AxLab-UofC/GranularIO/Hardware/LAPM/4_MotherBoard_PCB/readme.md

# MotherBoard PCB
## Why are there no BOM and Pos files?
This mother board is mainly for connecting motordrivers and 4 x teensy 3.2. The main components are pin headers and sockets with 2.54mm spacing.

## Publication

**Granular I/O: Enabling Bi-directional Malleable Interaction for Actuated TUIs with Magnetic Particles**  
Chi Wang, Clara Cui, Alan Pham, Justice T Andersen, Tucker Rae-Grant, and Ken Nakagaki.  
*ACM Symposium on User Interface Software and Technology (UIST), 2026.*  
https://doi.org/10.1145/3830398.3830589
