AxLab-UofC/GranularIO/Hardware/EM/EM_Bottom.png

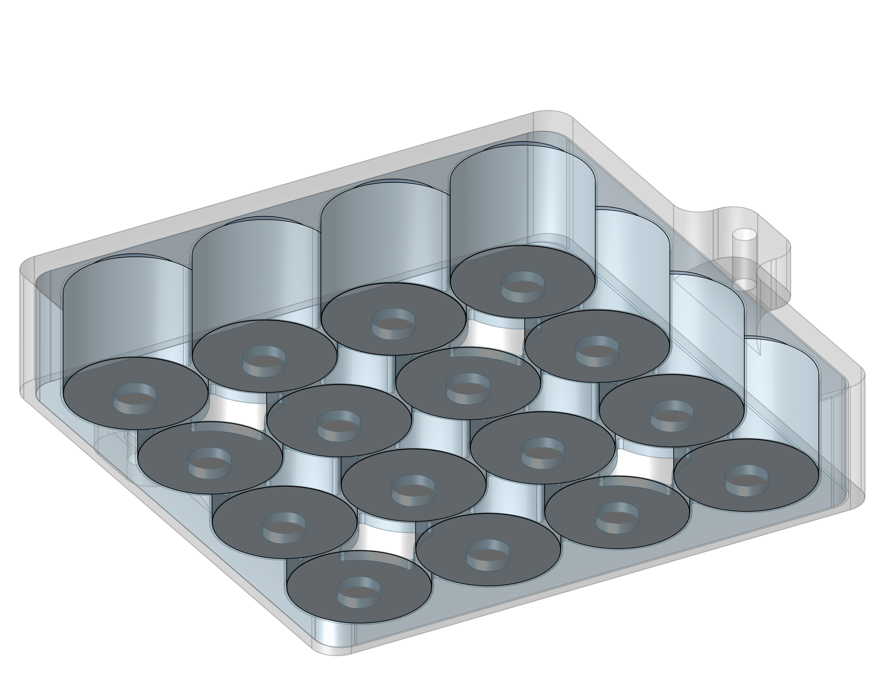
Hardware/EM/EM_Bottom.png
