AxLab-UofC/GranularIO/Hardware/LAPM/5_MotorDriver_PCB/MotorDriver_BOM.csv

Reference | Qty | Value | DNP | Exclude from BOM | Exclude from Board | Footprint | Datasheet | LCSC
C1,C2 | 2 | 47uF/16V |  |  |  | Capacitor_SMD:CP_Elec_6.3x5.4 | ~
C3,C4 | 2 | 10uF |  |  |  | Capacitor_SMD:C_0603_1608Metric_Pad1.08x0.95mm_HandSolder | ~
C5 | 1 | 0.1uF |  |  |  | Capacitor_SMD:C_0603_1608Metric_Pad1.08x0.95mm_HandSolder | ~
D1 | 1 | LED |  |  |  | LED_SMD:LED_0603_1608Metric_Pad1.05x0.95mm_HandSolder | ~
J1 | 1 | Conn_01x12_Pin |  |  |  | Connector_PinHeader_2.54mm:PinHeader_2x06_P2.54mm_Vertical_SMD | ~ | C22395610
J2,J3 | 2 | Conn_01x01_Pin |  |  |  | Connector_PinHeader_2.54mm:PinHeader_1x01_P2.54mm_Vertical | ~
JP1,JP2,JP3,JP4,JP5 | 5 | ~ |  | Excluded from BOM |  | Jumper:SolderJumper-2_P1.3mm_Open_RoundedPad1.0x1.5mm | ~
M1,M2,M3,M4 | 4 | N20Motor |  |  |  | N20Motor:N20MotorConn | ~
R9 | 1 | 1k |  |  |  | Resistor_SMD:R_0603_1608Metric_Pad0.98x0.95mm_HandSolder | ~
RN1,RN2 | 2 | 10k |  |  |  | Resistor_SMD:R_Array_Convex_4x0603 | ~ | C29718
U1 | 1 | PCA9685PW |  |  |  | Package_SO:TSSOP-28_4.4x9.7mm_P0.65mm | http://www.nxp.com/docs/en/data-sheet/PCA9685.pdf | C2678753
U2,U3 | 2 | TB6612FNG |  |  |  | Package_SO:SSOP-24_5.3x8.2mm_P0.65mm | https://toshiba.semicon-storage.com/us/product/linear/motordriver/detail.TB6612FNG.html | C141517
