AxLab-UofC/GranularIO/Hardware/EM/1_EM_Cover.stl

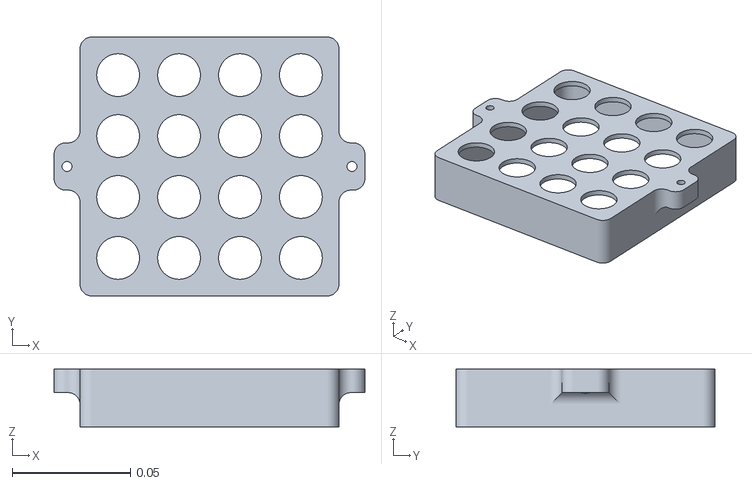
[picture p6: CAD file, 2026-11-02]
Hardware/EM/1_EM_Cover.stl
0.131 x 0.109 x 0.0245
