AxLab-UofC/GranularIO/Hardware/LAPM/1_Rail_Array.stl

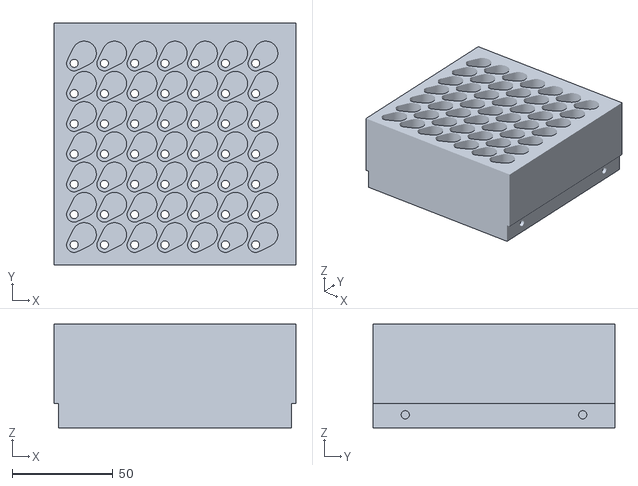
[picture p7: CAD file, 2026-11-02]
Hardware/LAPM/1_Rail_Array.stl
120.0 x 120.0 x 51.5
