AxLab-UofC/GranularIO/Hardware/LAPM/4_MotherBoard_PCB/MotherBoard_3D_Model.step

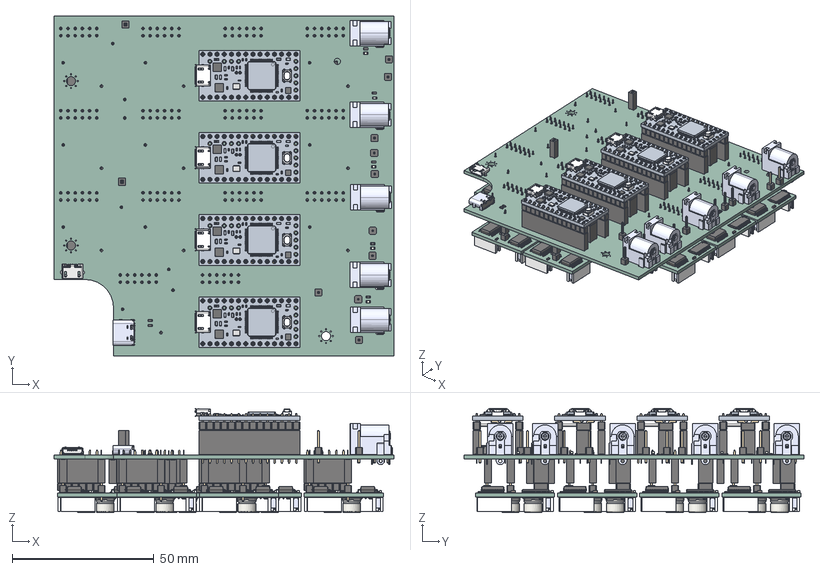
[picture p9: CAD file, 2026-10-10]
Hardware/LAPM/4_MotherBoard_PCB/MotherBoard_3D_Model.step
120.0 x 120.0 x 36.9 mm
PinSocket_2x06_P2.54mm_Vertical x 18
PinSocket_1x01_P2.54mm_Vertical x 36
C_0603_1608Metric x 42
PinHeader_2x06_P2.54mm_Vertical_SMD x 18
PinHeader_1x01_P2.54mm_Vertical x 38
R_Array_Convex_4x0603 x 28
R_0603_1608Metric x 21
SSOP-24_5.3x8.2mm_P0.65mm x 28
TSSOP-28_4.4x9.7mm_P0.65mm x 14
LED_0603_1608Metric x 19
BxB-ZR-SM4_6 x 56
BxB-ZR-SM4 pins_6 x 56
CP_Elec_6.3x5.4 x 28
MotorController_PCB x 14
PinSocket_1x14_P2.54mm_Vertical x 8
PinHeader_1x14_P2.54mm_Vertical x 8
PJ-002B x 5
MCR-B-S-RA-SMT-CS5A-NF-T_R
USB4105GFA_USB4105GFA
MotorHub5x5_PCB
