AxLab-UofC/GranularIO/Hardware/LAPM/5_MotorDriver_PCB/MotorDriver_3D_Model.step

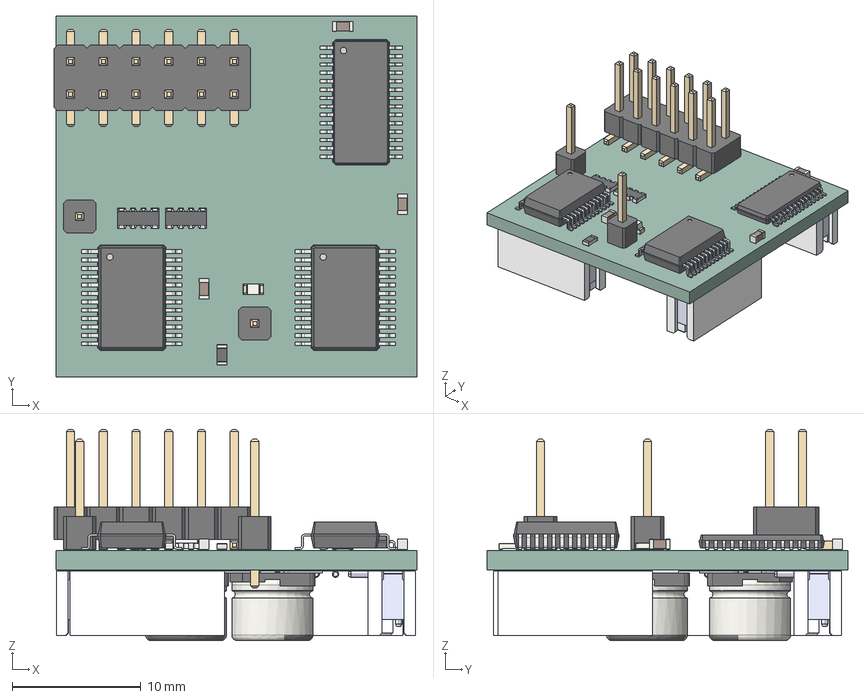
[picture p10: CAD file, 2026-10-10]
Hardware/LAPM/5_MotorDriver_PCB/MotorDriver_3D_Model.step
28.1 x 28.0 x 16.4 mm
C_0603_1608Metric x 3
PinHeader_2x06_P2.54mm_Vertical_SMD
PinHeader_1x01_P2.54mm_Vertical x 2
R_Array_Convex_4x0603 x 2
R_0603_1608Metric
SSOP-24_5.3x8.2mm_P0.65mm x 2
TSSOP-28_4.4x9.7mm_P0.65mm
LED_0603_1608Metric
BxB-ZR-SM4_6 x 4
BxB-ZR-SM4 pins_6 x 4
CP_Elec_6.3x5.4 x 2
MotorController_PCB
