AxLab-UofC/GranularIO/Hardware/EM/2_EM_Hub.stl

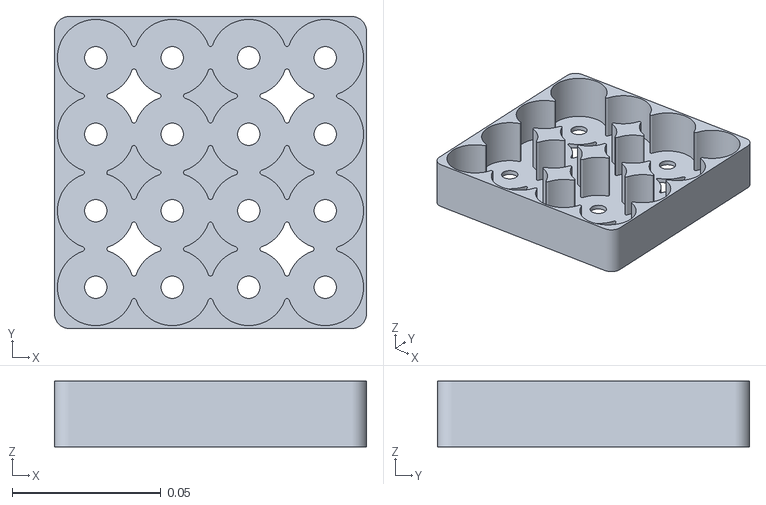
[picture p11: CAD file, 2026-11-02]
Hardware/EM/2_EM_Hub.stl
0.105 x 0.105 x 0.0221
