AxLab-UofC/GranularIO/Hardware/LAPM/2_Motor_Hub.stl

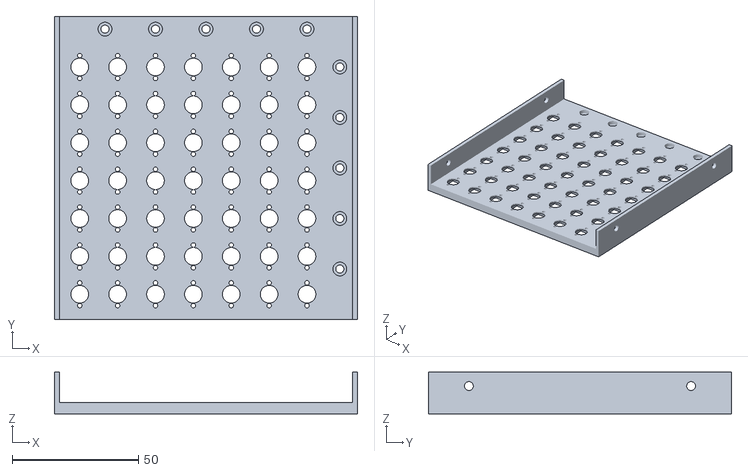
[picture p12: CAD file, 2026-11-02]
Hardware/LAPM/2_Motor_Hub.stl
120.0 x 120.0 x 16.5
