AxLab-UofC/GranularIO/Hardware/LAPM/3_Supporting_Beams/3_Supporting_Beam_d.stl

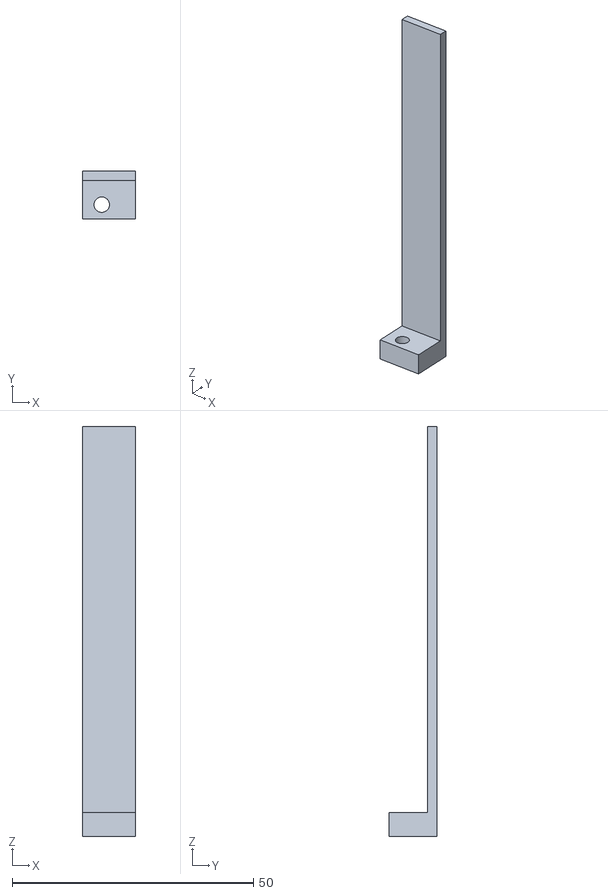
[picture p13: CAD file, 2026-11-02]
Hardware/LAPM/3_Supporting_Beams/3_Supporting_Beam_d.stl
11.0 x 10.0 x 85.0
