AxLab-UofC/GranularIO/Hardware/LAPM/6_Pin/6_3_Encoder_Cap.stl

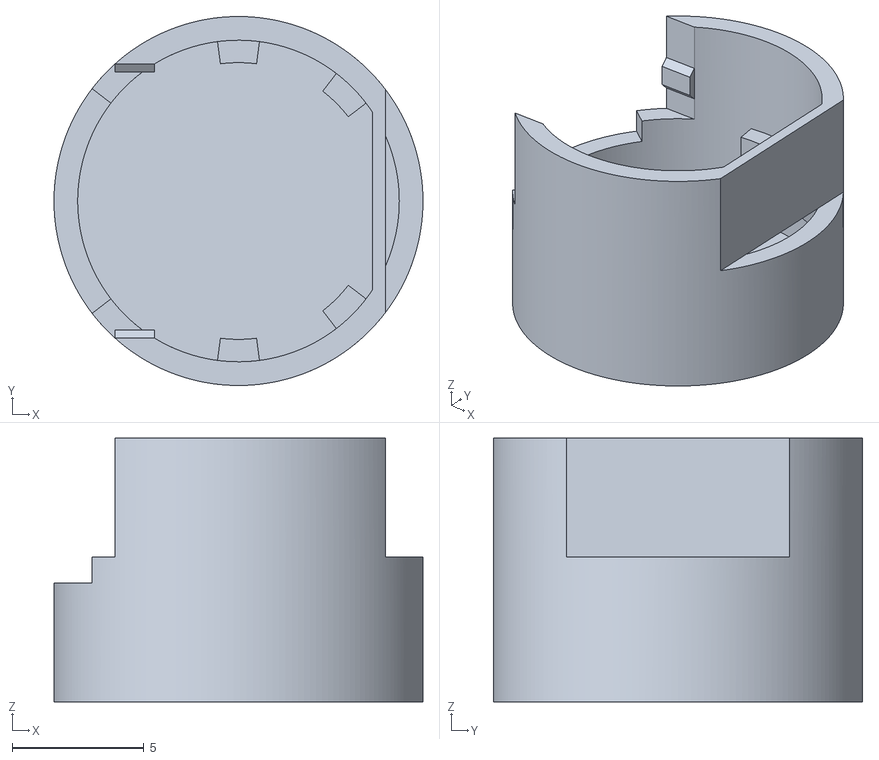
[picture p14: CAD file, 2026-11-02]
Hardware/LAPM/6_Pin/6_3_Encoder_Cap.stl
14.0 x 14.0 x 10.0
