AxLab-UofC/GranularIO/Hardware/EM/3_MetalDisk.step

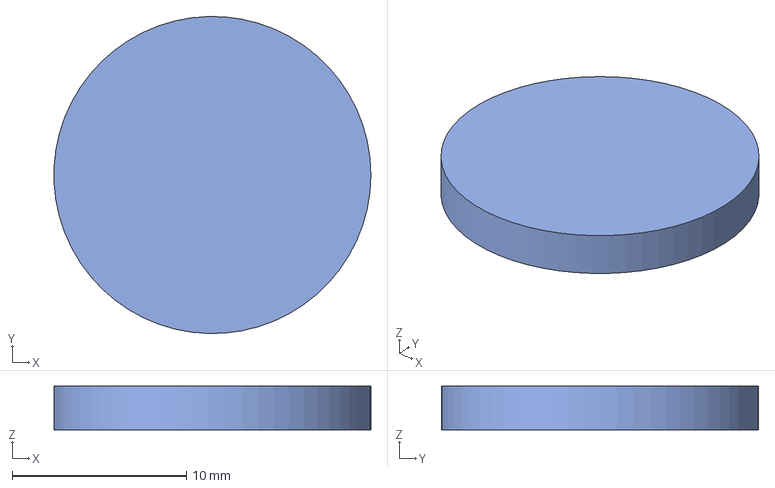
[picture p15: CAD file, 2026-11-02]
Hardware/EM/3_MetalDisk.step
18.2 x 18.2 x 2.50 mm
