AxLab-UofC/GranularIO/Hardware/LAPM/3_Supporting_Beams/3_Supporting_Beam_c.stl

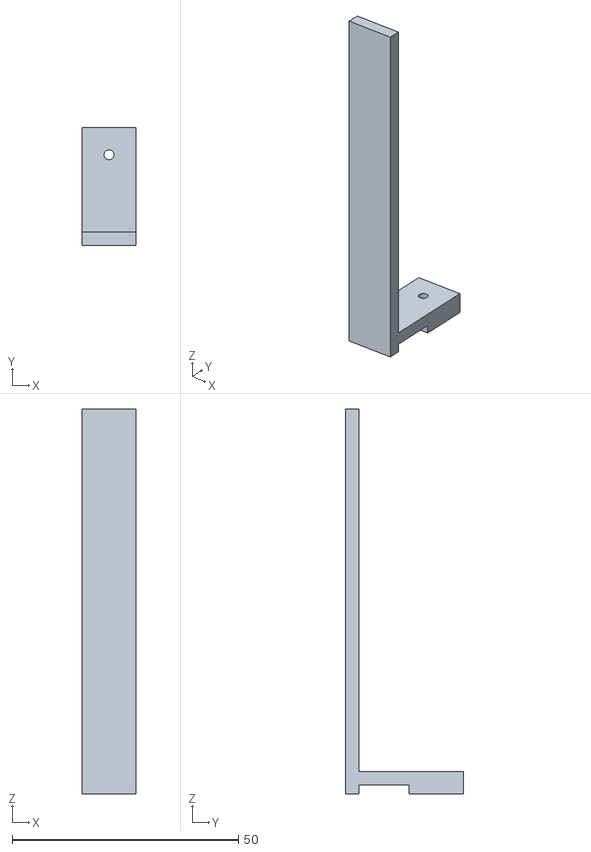
[picture p16: CAD file, 2026-11-02]
Hardware/LAPM/3_Supporting_Beams/3_Supporting_Beam_c.stl
12.0 x 26.0 x 85.0
