AxLab-UofC/GranularIO/Hardware/LAPM/6_Pin/6_1_Magnet_Holder.stl

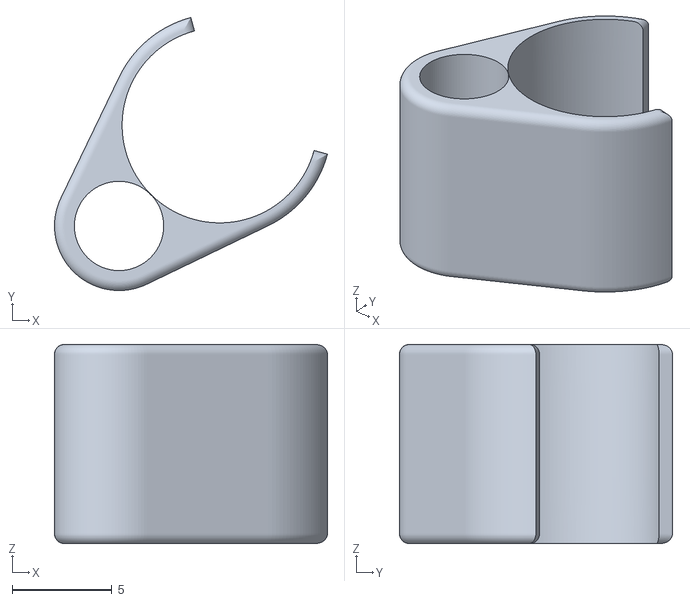
[picture p17: CAD file, 2026-11-02]
Hardware/LAPM/6_Pin/6_1_Magnet_Holder.stl
13.7 x 13.7 x 10.0
