AxLab-UofC/GranularIO/Hardware/LAPM/3_Supporting_Beams/3_Supporting_Beam_b.stl

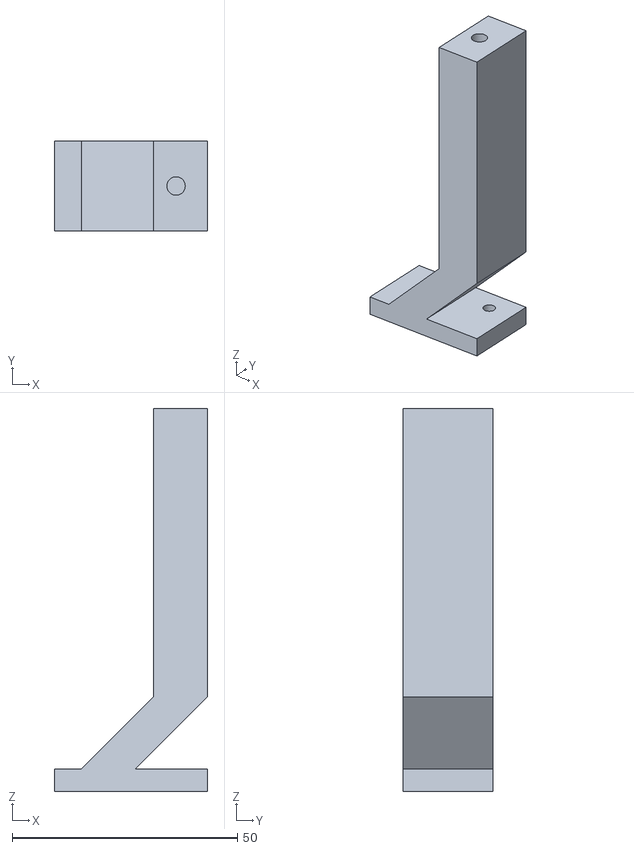
[picture p18: CAD file, 2026-11-02]
Hardware/LAPM/3_Supporting_Beams/3_Supporting_Beam_b.stl
34.0 x 20.0 x 85.0
