AxLab-UofC/GranularIO/Hardware/LAPM/6_Pin/6_2_Screw_Connector.stl

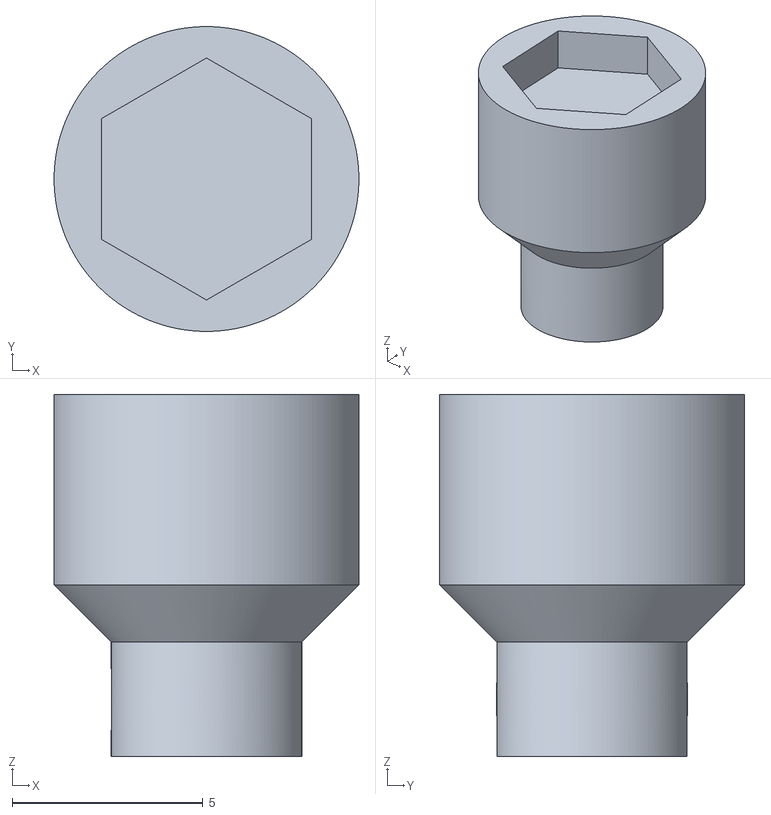
[picture p19: CAD file, 2026-11-02]
Hardware/LAPM/6_Pin/6_2_Screw_Connector.stl
8.00 x 8.00 x 9.50
