AxLab-UofC/GranularIO/(list of files, cad)

Other CAD files:
Hardware/Particles/Sphere_5mm_mini.3mf
Hardware/Particles/Sphere_5mm_support_test.3mf
