AxLab-UofC/GranularIO/Hardware/LAPM/4_MotherBoard_PCB/MotherBoard_PCB_B.pdf

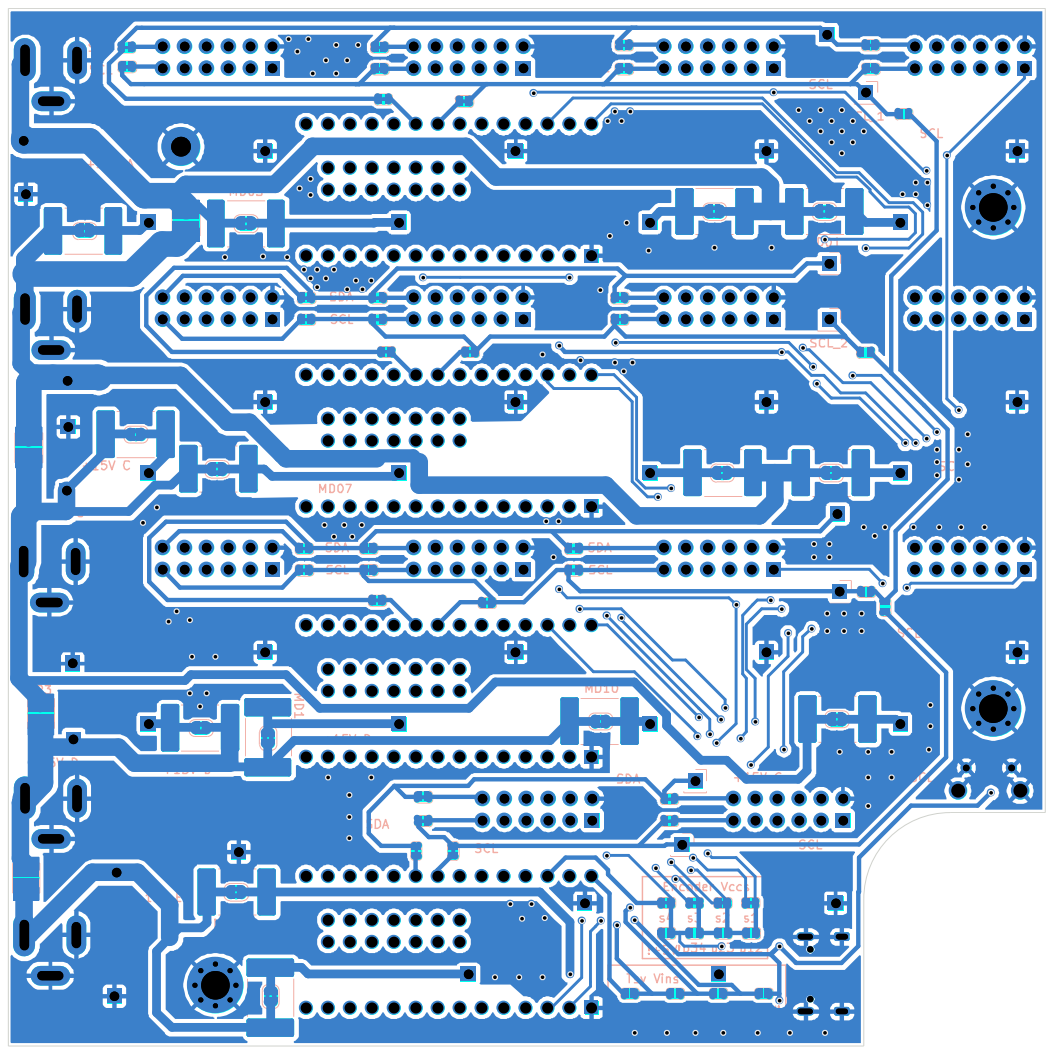
[picture p20: page 1]
