AxLab-UofC/GranularIO/Hardware/LAPM/4_MotherBoard_PCB/MotherBoard_PCB_F.pdf

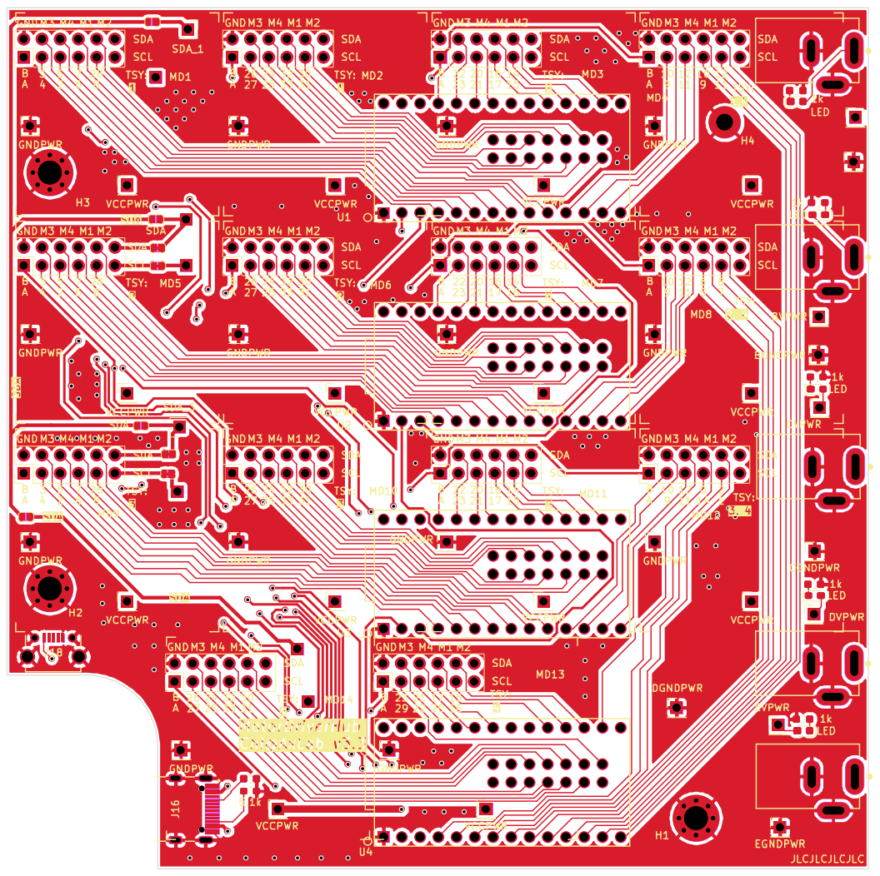
[picture p21: page 1]
