AxLab-UofC/GranularIO/Hardware/LAPM/4_MotherBoard_PCB/MotherBoard_Schematic.pdf

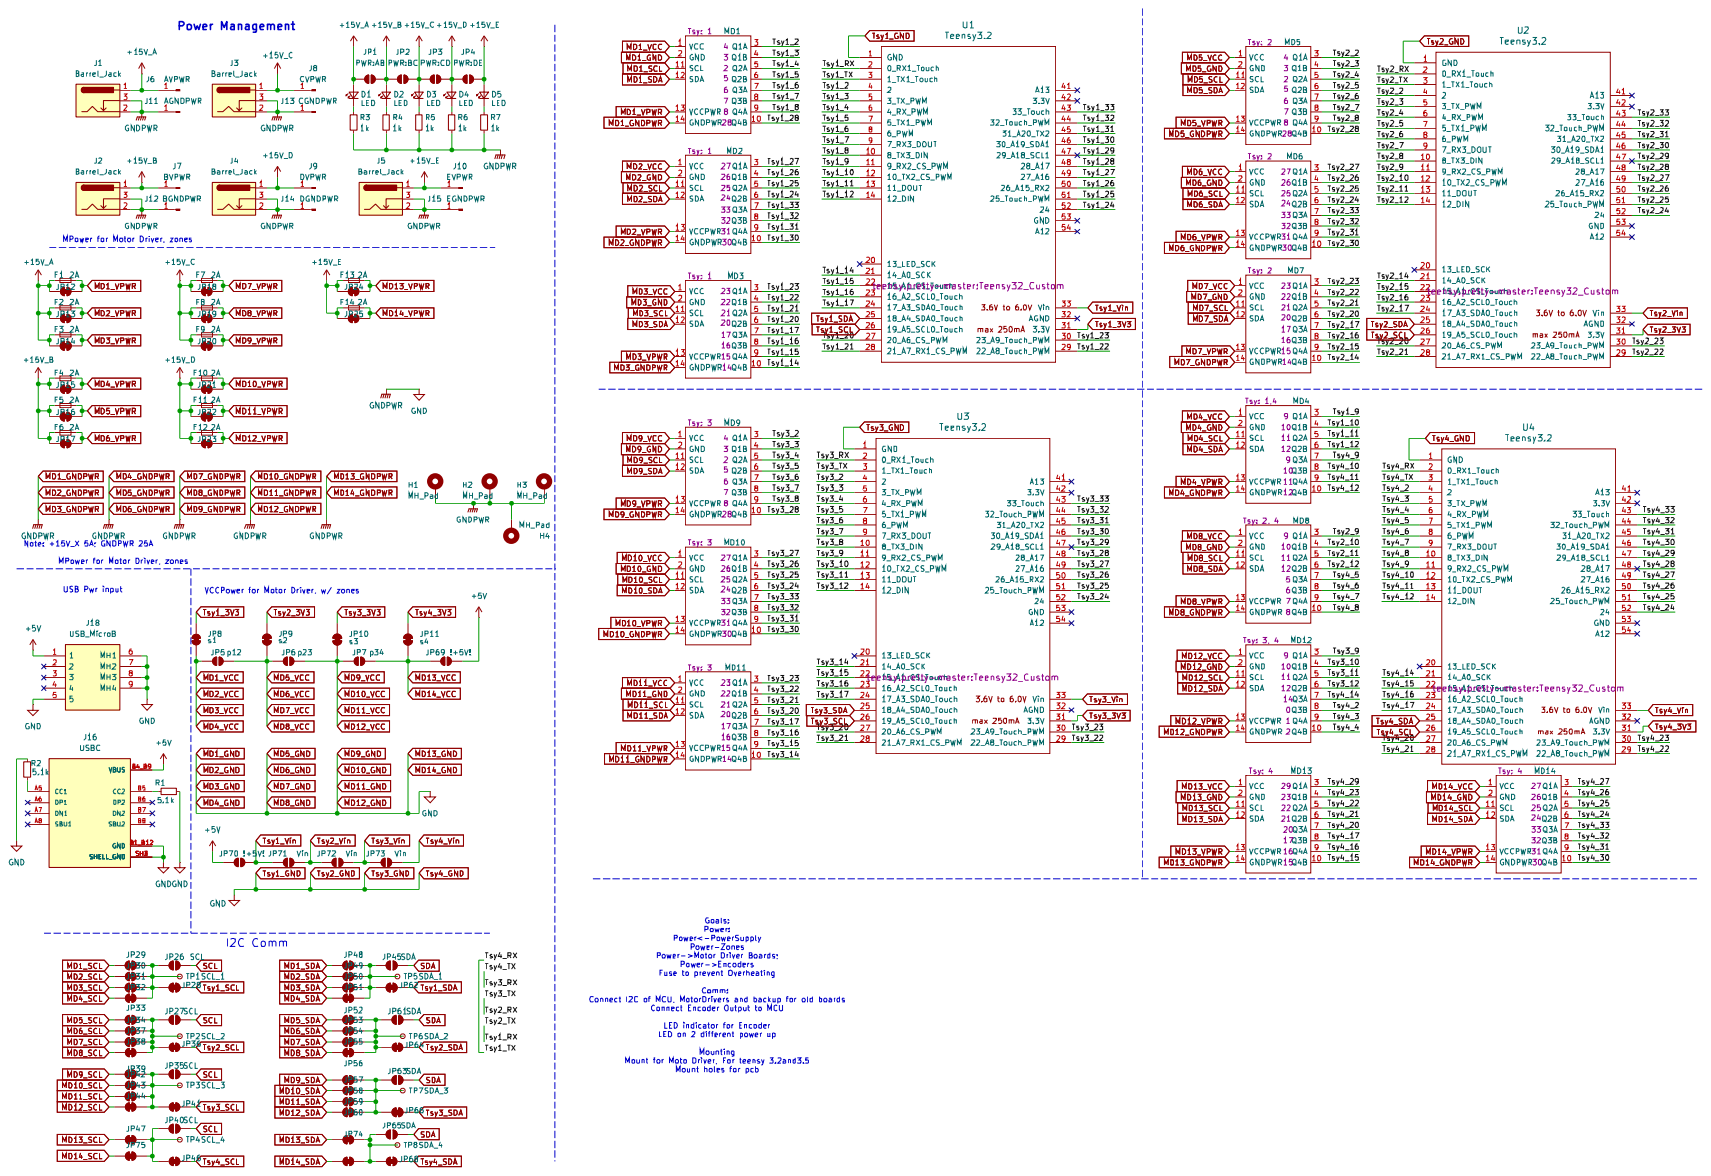
[picture p22: page 1]
