AxLab-UofC/GranularIO/Hardware/LAPM/5_MotorDriver_PCB/MotorDriver_PCB_B.pdf

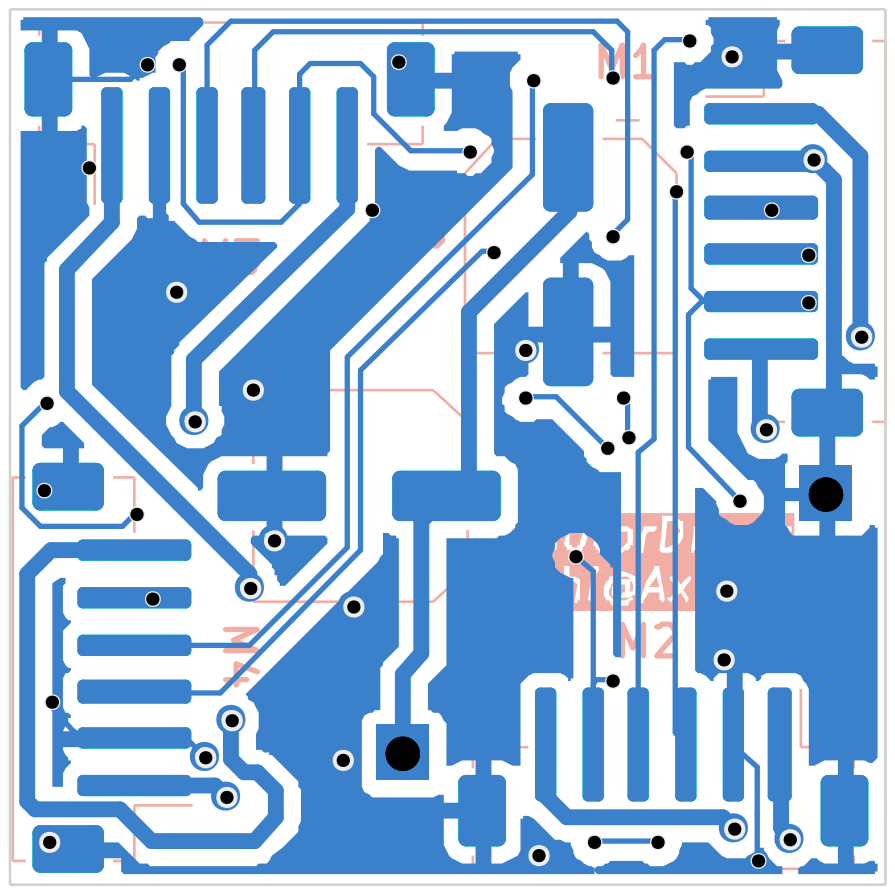
[picture p23: page 1]
