AxLab-UofC/GranularIO/Hardware/LAPM/5_MotorDriver_PCB/MotorDriver_PCB_F.pdf

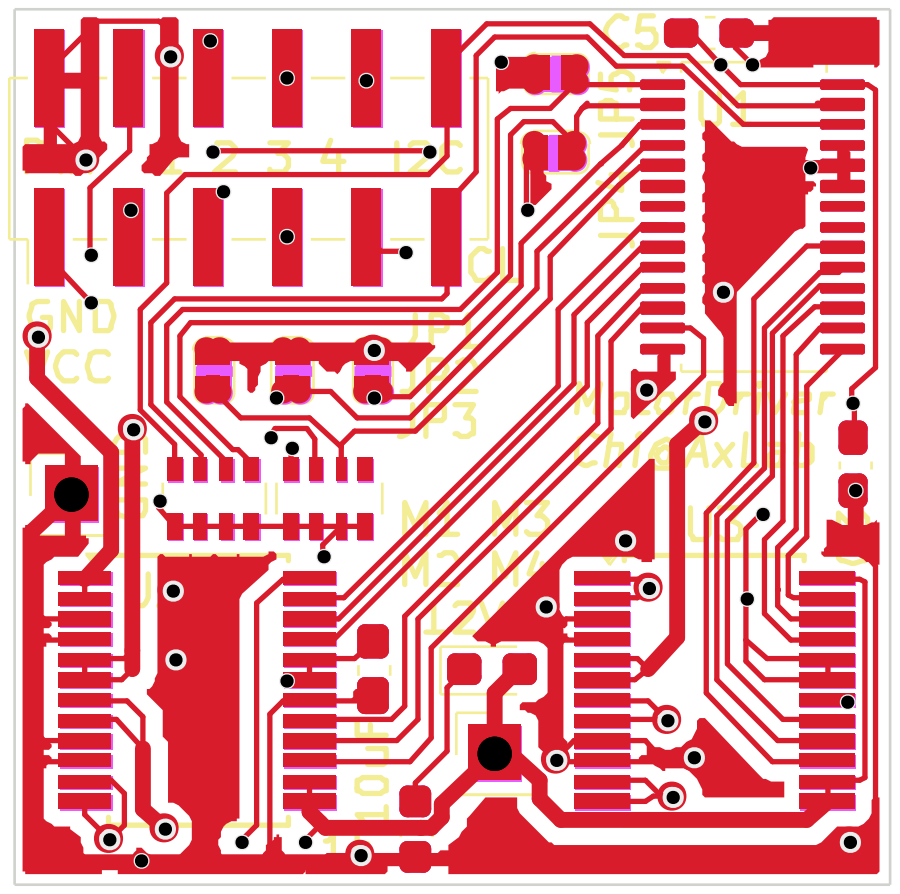
[picture p24: page 1]
