AxLab-UofC/GranularIO/Hardware/LAPM/5_MotorDriver_PCB/MotorDriver_Schematic.pdf

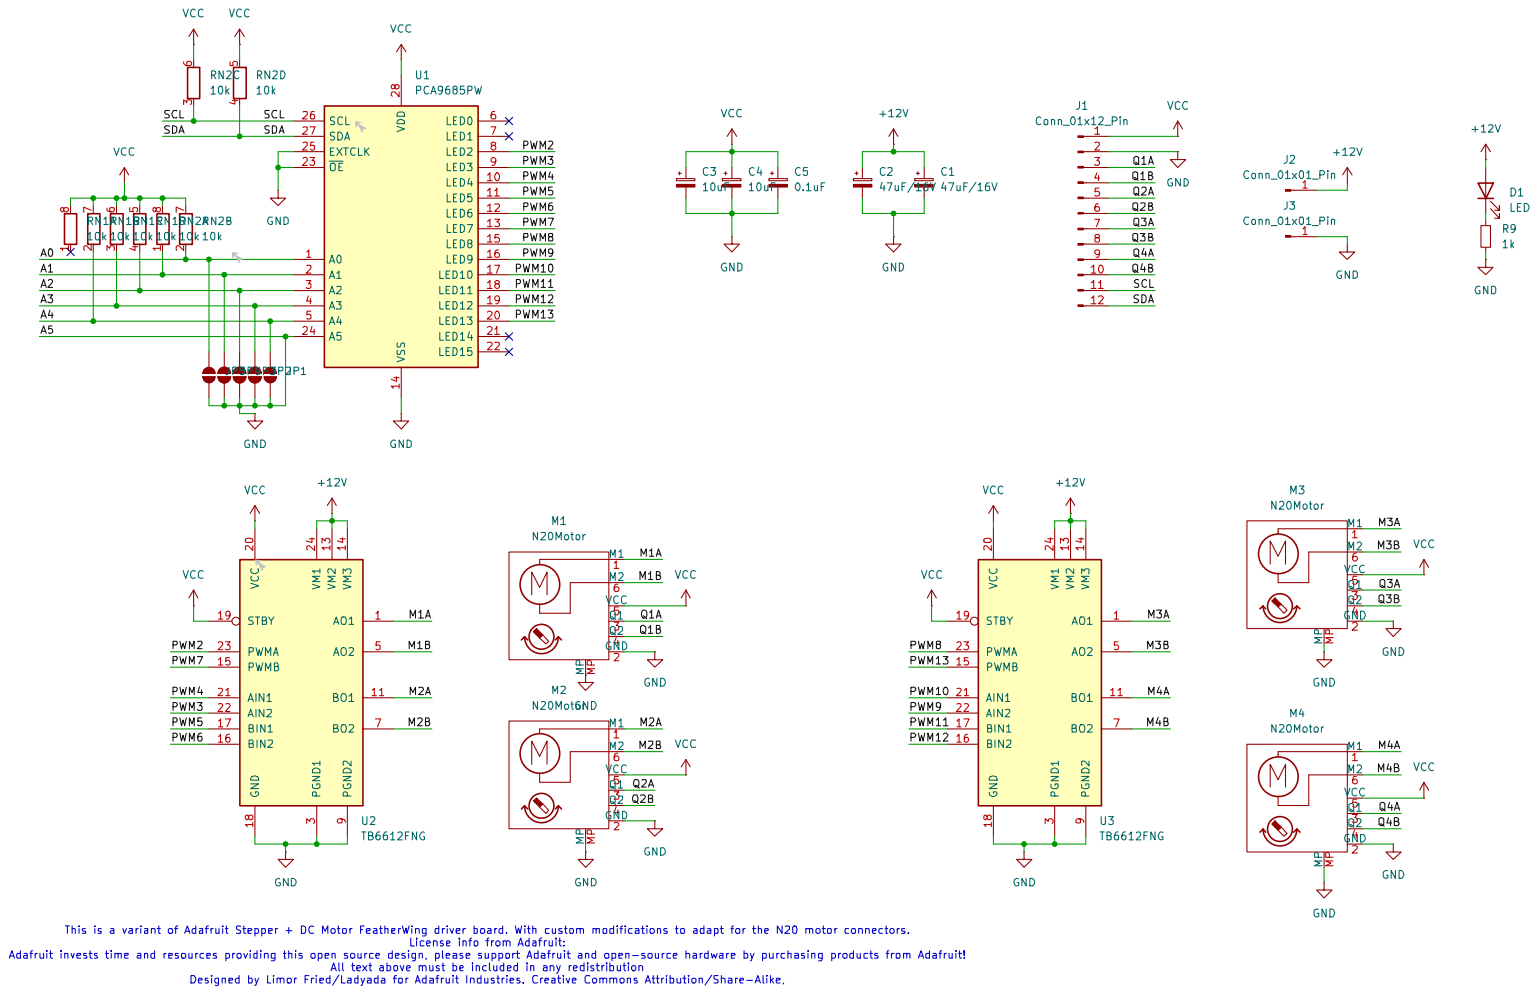
[picture p25: page 1]
