AxLab-UofC/GranularIO/Hardware/LAPM/PCB Kicad Files/4_MotherBoard_PCB/MotorHub5x5.kicad_pcb

## KiCad design Hardware/LAPM/PCB Kicad Files/4_MotherBoard_PCB/MotorHub5x5.kicad_pcb (2026-10-10)

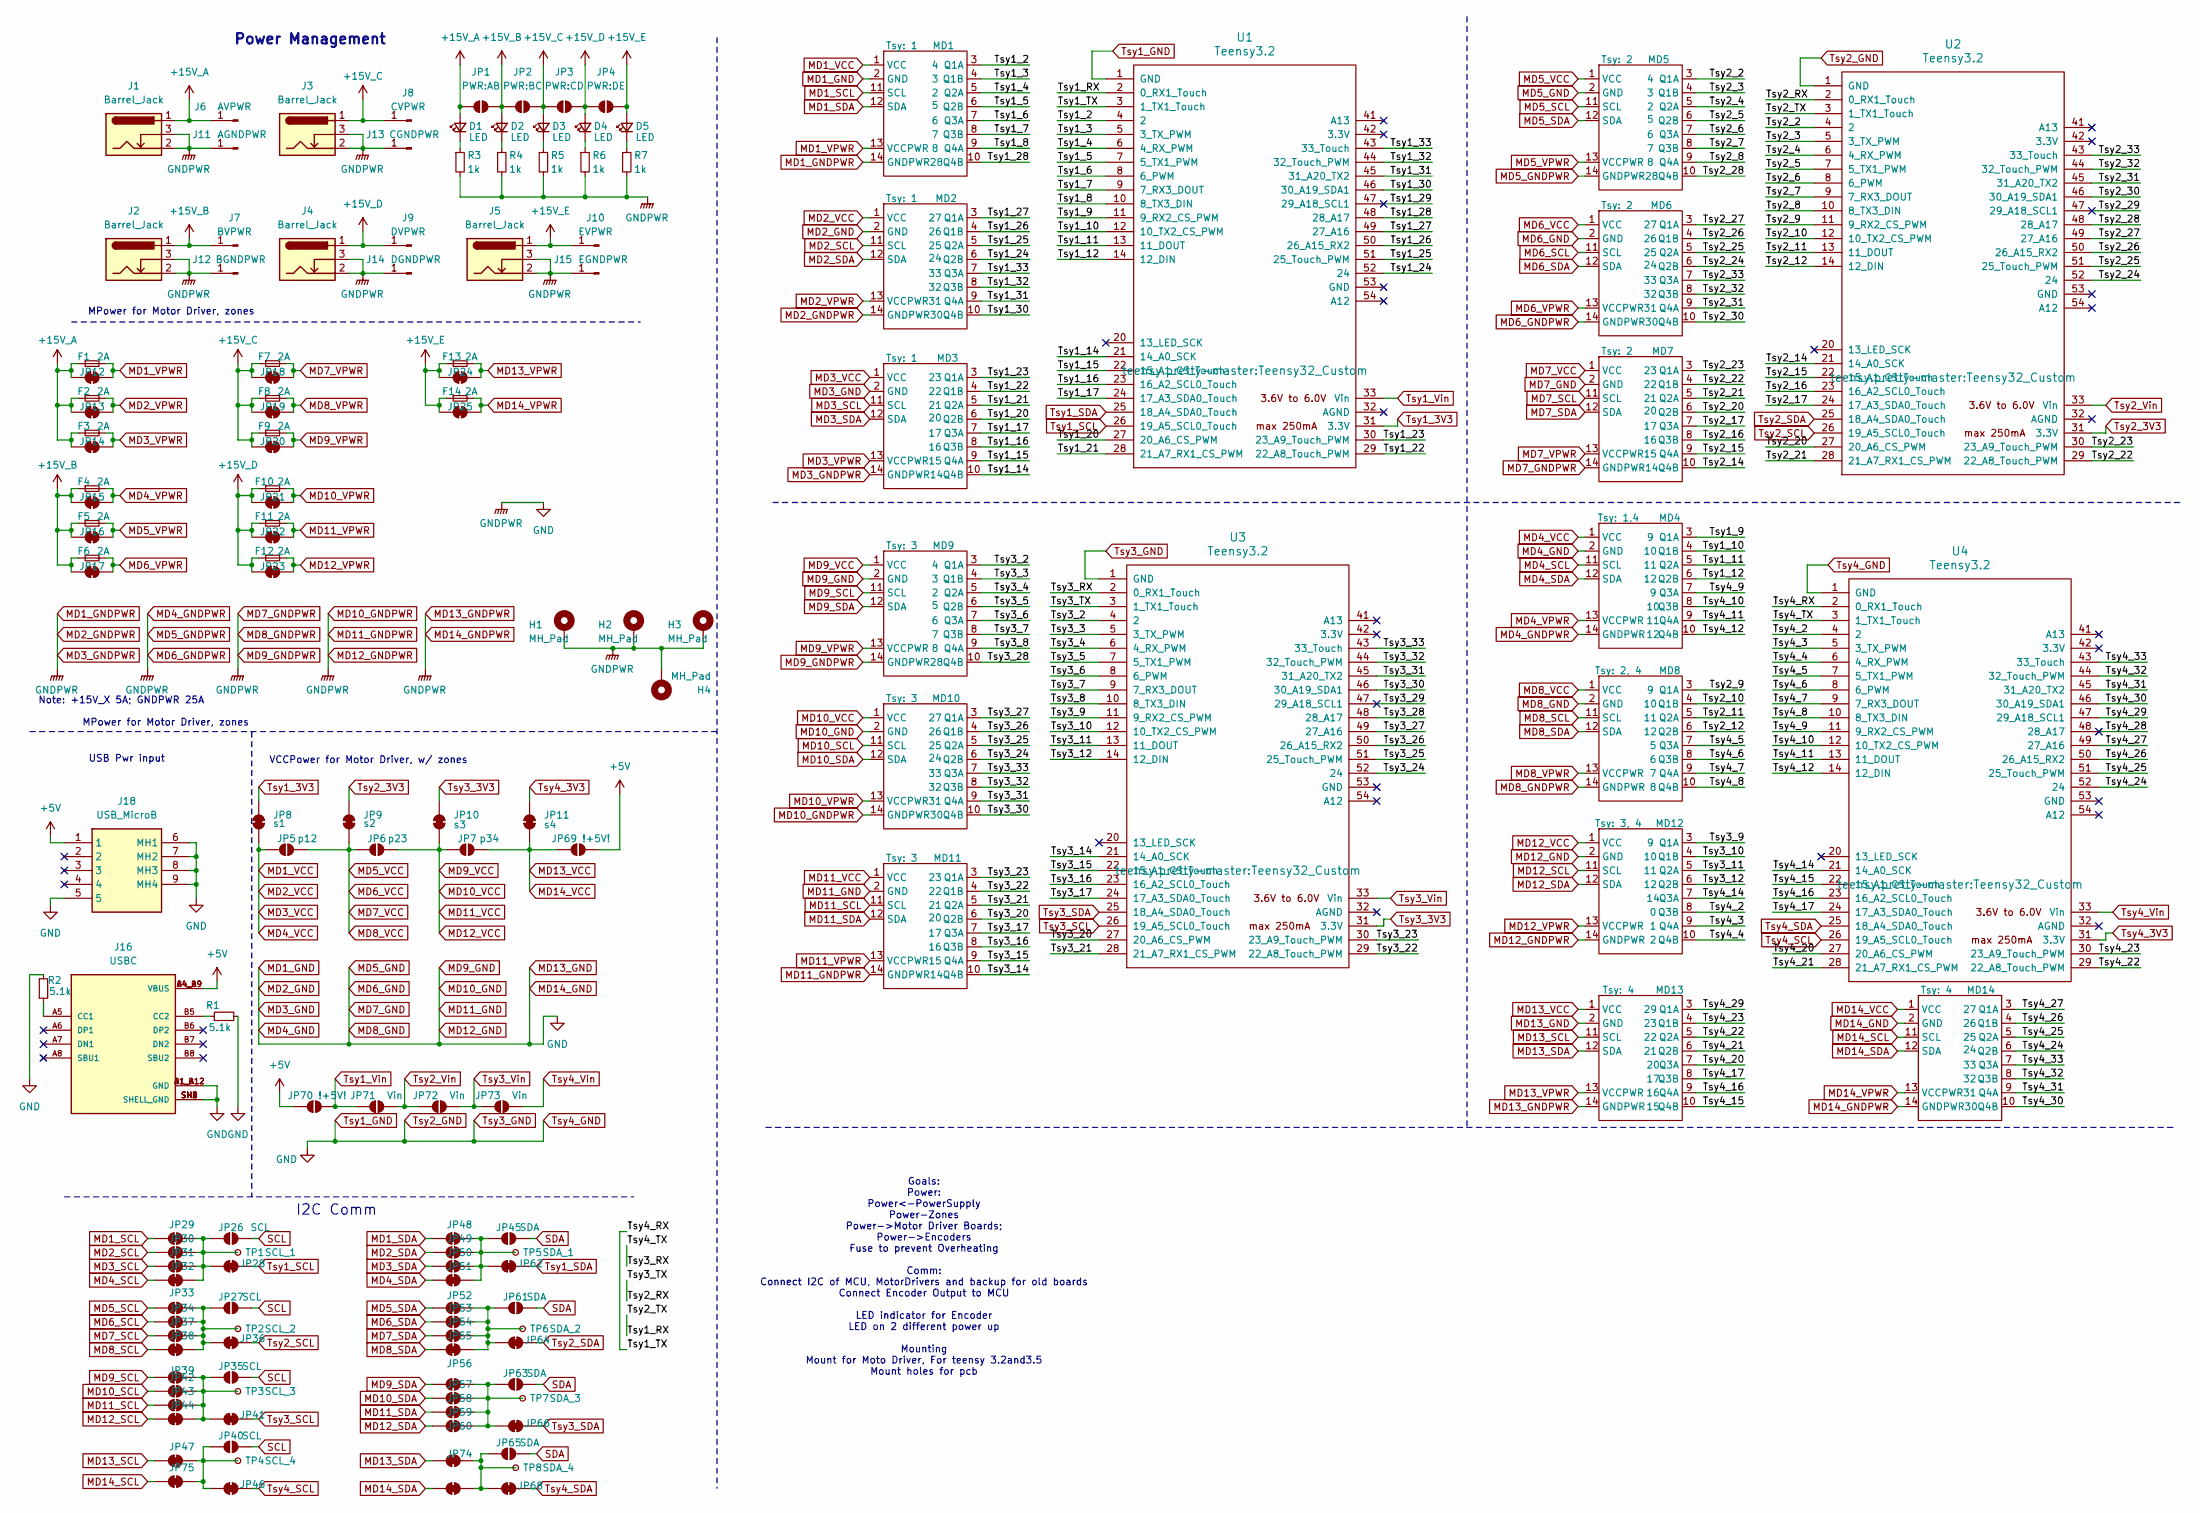
[picture p26: schematic MotorHub5x5.kicad_sch]

Parts:
D1, D2, D3, D4, D5: LED; LED_0603_1608Metric_Pad1.05x0.95mm_HandSolder
F1, F2, F3, F4, F5, F6, F7, F8, F9, F10, F11, F12, F13, F14: 2A; Fuse_2920_7451Metric_Pad2.10x5.45mm_HandSolder_custom
H1, H2, H3: MH_Pad; MountingHole_3.2mm_M3_Pad_Via
H4: MH_Pad; MountingHole_2.2mm_M2_Pad
J1, J2, J3, J4, J5: Barrel_Jack; DC_Barral_JackCUI_PJ-002B
J6: AVPWR; PinHeader_1x01_P2.54mm_Vertical
J7: BVPWR; PinHeader_1x01_P2.54mm_Vertical
J8: CVPWR; PinHeader_1x01_P2.54mm_Vertical
J9: DVPWR; PinHeader_1x01_P2.54mm_Vertical
J10: EVPWR; PinHeader_1x01_P2.54mm_Vertical
J11: AGNDPWR; PinHeader_1x01_P2.54mm_Vertical
J12: BGNDPWR; PinHeader_1x01_P2.54mm_Vertical
J13: CGNDPWR; PinHeader_1x01_P2.54mm_Vertical
J14: DGNDPWR; PinHeader_1x01_P2.54mm_Vertical
J15: EGNDPWR; PinHeader_1x01_P2.54mm_Vertical
J16: USBC; GCT_USB4105-GF-A
J18: USB_MicroB; MCRBSRASMTCS5ANFTR; Mouser Part Number 737-RBSRASMTCS5ANFTR
JP1: PWR:AB; SolderJumper-2_P3mm_Open_RectPad
JP2: PWR:BC; SolderJumper-2_P3mm_Open_RectPad
JP3: PWR:CD; SolderJumper-2_P3mm_Open_RectPad
JP4: PWR:DE; SolderJumper-2_P3mm_Open_RectPad
JP5: p12; SolderJumper-2_Open_RoundedPad
JP6: p23; SolderJumper-2_Open_RoundedPad
JP7: p34; SolderJumper-2_Open_RoundedPad
JP8: s1; SolderJumper-2_Bridged_RoundedPad
JP9: s2; SolderJumper-2_Bridged_RoundedPad
JP10: s3; SolderJumper-2_Bridged_RoundedPad
JP11: s4; SolderJumper-2_Bridged_RoundedPad
JP12: DM1; SolderJumper-2_P1.3mm_Bridged2Bar_RoundedPad1.0x1.5mm
JP13: DM2; SolderJumper-2_P1.3mm_Bridged2Bar_RoundedPad1.0x1.5mm
JP14: DM3; SolderJumper-2_P1.3mm_Bridged2Bar_RoundedPad1.0x1.5mm
JP15: DM4; SolderJumper-2_P1.3mm_Bridged2Bar_RoundedPad1.0x1.5mm
JP16: DM5; SolderJumper-2_P1.3mm_Bridged2Bar_RoundedPad1.0x1.5mm
JP17: DM6; SolderJumper-2_P1.3mm_Bridged2Bar_RoundedPad1.0x1.5mm
JP18: DM7; SolderJumper-2_P1.3mm_Bridged2Bar_RoundedPad1.0x1.5mm
JP19: DM8; SolderJumper-2_P1.3mm_Bridged2Bar_RoundedPad1.0x1.5mm
JP20: DM9; SolderJumper-2_P1.3mm_Bridged2Bar_RoundedPad1.0x1.5mm
JP21: DM10; SolderJumper-2_P1.3mm_Bridged2Bar_RoundedPad1.0x1.5mm
JP22: DM11; SolderJumper-2_P1.3mm_Bridged2Bar_RoundedPad1.0x1.5mm
JP23: DM12; SolderJumper-2_P1.3mm_Bridged2Bar_RoundedPad1.0x1.5mm
JP24, JP25: DM13; SolderJumper-2_P1.3mm_Bridged2Bar_RoundedPad1.0x1.5mm
JP26, JP27, JP35, JP40: SCL; SolderJumper-2_Open_RoundedPad
JP28, JP29, JP30, JP31, JP32, JP33, JP34, JP36, JP37, JP38, JP39, JP41, JP42, JP43, JP44, JP46, JP47, JP48, JP49, JP50, JP51, JP52, JP53, JP54, JP55, JP56, JP57, JP58, JP59, JP60, JP62, JP64, JP66, JP68, JP74, JP75: SolderJumper_2_Bridged; SolderJumper-2_Bridged_RoundedPad
JP45, JP61, JP63, JP65: SDA; SolderJumper-2_Open_RoundedPad
JP69, JP70: !+5V!; SolderJumper-2_Open_RoundedPad
JP71, JP72, JP73: Vin; SolderJumper-2_Open_RoundedPad
MD1, MD2, MD3, MD4, MD5, MD6, MD7, MD8, MD9, MD10, MD11, MD12, MD13, MD14: MotorDriverConn
R1, R2: 5.1k; R_0603_1608Metric_Pad0.98x0.95mm_HandSolder
R3, R4, R5, R6, R7: 1k; R_0603_1608Metric_Pad0.98x0.95mm_HandSolder
TP1: SCL_1; PinSocket_1x01_P2.54mm_Vertical
TP2: SCL_2; PinSocket_1x01_P2.54mm_Vertical
TP3: SCL_3; PinSocket_1x01_P2.54mm_Vertical
TP4: SCL_4; PinSocket_1x01_P2.54mm_Vertical
TP5: SDA_1; PinSocket_1x01_P2.54mm_Vertical
TP6: SDA_2; PinSocket_1x01_P2.54mm_Vertical
TP7: SDA_3; PinSocket_1x01_P2.54mm_Vertical
TP8: SDA_4; PinSocket_1x01_P2.54mm_Vertical
U1, U2, U3, U4: Teensy3.2; Teensy32_Custom

Connections:
+5V: J16.A4_B9 (VBUS), J16.B4_A9 (VBUS), J18.1, JP69.2 (B), JP70.1 (A)
+15V_A: D1.2 (A), F1.1, F2.1, F3.1, J1.1, J6.1, JP1.1 (A), JP12.1 (A), JP13.1 (A), JP14.1 (A)
+15V_B: D2.2 (A), F4.1, F5.1, F6.1, J2.1, J7.1, JP1.2 (B), JP2.1 (A), JP15.1 (A), JP16.1 (A), JP17.1 (A)
+15V_C: D3.2 (A), F7.1, F8.1, F9.1, J3.1, J8.1, JP2.2 (B), JP3.1 (A), JP18.1 (A), JP19.1 (A), JP20.1 (A)
+15V_D: D4.2 (A), F10.1, F11.1, F12.1, J4.1, J9.1, JP3.2 (B), JP4.1 (A), JP21.1 (A), JP22.1 (A), JP23.1 (A)
+15V_E: D5.2 (A), F13.1, F14.1, J5.1, J10.1, JP4.2 (B), JP24.1 (A), JP25.1 (A)
/Tsy1_2: MD1.3 (Q1A), U1.4 (2)
/Tsy1_3: MD1.4 (Q1B), U1.5 (3_TX_PWM)
/Tsy1_4: MD1.5 (Q2A), U1.6 (4_RX_PWM)
/Tsy1_5: MD1.6 (Q2B), U1.7 (5_TX1_PWM)
/Tsy1_6: MD1.7 (Q3A), U1.8 (6_PWM)
/Tsy1_7: MD1.8 (Q3B), U1.9 (7_RX3_DOUT)
/Tsy1_8: MD1.9 (Q4A), U1.10 (8_TX3_DIN)
/Tsy1_9: MD4.3 (Q1A), U1.11 (9_RX2_CS_PWM)
/Tsy1_10: MD4.4 (Q1B), U1.12 (10_TX2_CS_PWM)
/Tsy1_11: MD4.5 (Q2A), U1.13 (11_DOUT)
/Tsy1_12: MD4.6 (Q2B), U1.14 (12_DIN)
/Tsy1_14: MD3.10 (Q4B), U1.21 (14_A0_SCK)
/Tsy1_15: MD3.9 (Q4A), U1.22 (15_A1_CS_Touch)
/Tsy1_16: MD3.8 (Q3B), U1.23 (16_A2_SCL0_Touch)
/Tsy1_17: MD3.7 (Q3A), U1.24 (17_A3_SDA0_Touch)
/Tsy1_20: MD3.6 (Q2B), U1.27 (20_A6_CS_PWM)
/Tsy1_21: MD3.5 (Q2A), U1.28 (21_A7_RX1_CS_PWM)
/Tsy1_22: MD3.4 (Q1B), U1.29 (22_A8_Touch_PWM)
/Tsy1_23: MD3.3 (Q1A), U1.30 (23_A9_Touch_PWM)
/Tsy1_24: MD2.6 (Q2B), U1.52 (24)
/Tsy1_25: MD2.5 (Q2A), U1.51 (25_Touch_PWM)
/Tsy1_26: MD2.4 (Q1B), U1.50 (26_A15_RX2)
/Tsy1_27: MD2.3 (Q1A), U1.49 (27_A16)
/Tsy1_28: MD1.10 (Q4B), U1.48 (28_A17)
/Tsy1_29: U1.47 (29_A18_SCL1)
/Tsy1_30: MD2.10 (Q4B), U1.46 (30_A19_SDA1)
/Tsy1_31: MD2.9 (Q4A), U1.45 (31_A20_TX2)
/Tsy1_32: MD2.8 (Q3B), U1.44 (32_Touch_PWM)
/Tsy1_33: MD2.7 (Q3A), U1.43 (33_Touch)
/Tsy1_RX: U1.2 (0_RX1_Touch), U2.3 (1_TX1_Touch)
/Tsy1_TX: U1.3 (1_TX1_Touch), U4.2 (0_RX1_Touch)
/Tsy2_2: MD5.3 (Q1A), U2.4 (2)
/Tsy2_3: MD5.4 (Q1B), U2.5 (3_TX_PWM)
/Tsy2_4: MD5.5 (Q2A), U2.6 (4_RX_PWM)
/Tsy2_5: MD5.6 (Q2B), U2.7 (5_TX1_PWM)
/Tsy2_6: MD5.7 (Q3A), U2.8 (6_PWM)
/Tsy2_7: MD5.8 (Q3B), U2.9 (7_RX3_DOUT)
/Tsy2_8: MD5.9 (Q4A), U2.10 (8_TX3_DIN)
/Tsy2_9: MD8.3 (Q1A), U2.11 (9_RX2_CS_PWM)
/Tsy2_10: MD8.4 (Q1B), U2.12 (10_TX2_CS_PWM)
/Tsy2_11: MD8.5 (Q2A), U2.13 (11_DOUT)
/Tsy2_12: MD8.6 (Q2B), U2.14 (12_DIN)
/Tsy2_14: MD7.10 (Q4B), U2.21 (14_A0_SCK)
/Tsy2_15: MD7.9 (Q4A), U2.22 (15_A1_CS_Touch)
/Tsy2_16: MD7.8 (Q3B), U2.23 (16_A2_SCL0_Touch)
/Tsy2_17: MD7.7 (Q3A), U2.24 (17_A3_SDA0_Touch)
/Tsy2_20: MD7.6 (Q2B), U2.27 (20_A6_CS_PWM)
/Tsy2_21: MD7.5 (Q2A), U2.28 (21_A7_RX1_CS_PWM)
/Tsy2_22: MD7.4 (Q1B), U2.29 (22_A8_Touch_PWM)
/Tsy2_23: MD7.3 (Q1A), U2.30 (23_A9_Touch_PWM)
/Tsy2_24: MD6.6 (Q2B), U2.52 (24)
/Tsy2_25: MD6.5 (Q2A), U2.51 (25_Touch_PWM)
/Tsy2_26: MD6.4 (Q1B), U2.50 (26_A15_RX2)
/Tsy2_27: MD6.3 (Q1A), U2.49 (27_A16)
/Tsy2_28: MD5.10 (Q4B), U2.48 (28_A17)
/Tsy2_29: U2.47 (29_A18_SCL1)
/Tsy2_30: MD6.10 (Q4B), U2.46 (30_A19_SDA1)
/Tsy2_31: MD6.9 (Q4A), U2.45 (31_A20_TX2)
/Tsy2_32: MD6.8 (Q3B), U2.44 (32_Touch_PWM)
/Tsy2_33: MD6.7 (Q3A), U2.43 (33_Touch)
/Tsy2_RX: U2.2 (0_RX1_Touch), U3.3 (1_TX1_Touch)
/Tsy3_2: MD9.3 (Q1A), U3.4 (2)
/Tsy3_3: MD9.4 (Q1B), U3.5 (3_TX_PWM)
/Tsy3_4: MD9.5 (Q2A), U3.6 (4_RX_PWM)
/Tsy3_5: MD9.6 (Q2B), U3.7 (5_TX1_PWM)
/Tsy3_6: MD9.7 (Q3A), U3.8 (6_PWM)
/Tsy3_7: MD9.8 (Q3B), U3.9 (7_RX3_DOUT)
/Tsy3_8: MD9.9 (Q4A), U3.10 (8_TX3_DIN)
/Tsy3_9: MD12.3 (Q1A), U3.11 (9_RX2_CS_PWM)
/Tsy3_10: MD12.4 (Q1B), U3.12 (10_TX2_CS_PWM)
/Tsy3_11: MD12.5 (Q2A), U3.13 (11_DOUT)
/Tsy3_12: MD12.6 (Q2B), U3.14 (12_DIN)
/Tsy3_14: MD11.10 (Q4B), U3.21 (14_A0_SCK)
/Tsy3_15: MD11.9 (Q4A), U3.22 (15_A1_CS_Touch)
/Tsy3_16: MD11.8 (Q3B), U3.23 (16_A2_SCL0_Touch)
/Tsy3_17: MD11.7 (Q3A), U3.24 (17_A3_SDA0_Touch)
/Tsy3_20: MD11.6 (Q2B), U3.27 (20_A6_CS_PWM)
/Tsy3_21: MD11.5 (Q2A), U3.28 (21_A7_RX1_CS_PWM)
/Tsy3_22: MD11.4 (Q1B), U3.29 (22_A8_Touch_PWM)
/Tsy3_23: MD11.3 (Q1A), U3.30 (23_A9_Touch_PWM)
/Tsy3_24: MD10.6 (Q2B), U3.52 (24)
/Tsy3_25: MD10.5 (Q2A), U3.51 (25_Touch_PWM)
/Tsy3_26: MD10.4 (Q1B), U3.50 (26_A15_RX2)
/Tsy3_27: MD10.3 (Q1A), U3.49 (27_A16)
/Tsy3_28: MD9.10 (Q4B), U3.48 (28_A17)
/Tsy3_29: U3.47 (29_A18_SCL1)
/Tsy3_30: MD10.10 (Q4B), U3.46 (30_A19_SDA1)
/Tsy3_31: MD10.9 (Q4A), U3.45 (31_A20_TX2)
/Tsy3_32: MD10.8 (Q3B), U3.44 (32_Touch_PWM)
/Tsy3_33: MD10.7 (Q3A), U3.43 (33_Touch)
/Tsy3_RX: U3.2 (0_RX1_Touch), U4.3 (1_TX1_Touch)
/Tsy4_2: MD12.8 (Q3B), U4.4 (2)
/Tsy4_3: MD12.9 (Q4A), U4.5 (3_TX_PWM)
/Tsy4_4: MD12.10 (Q4B), U4.6 (4_RX_PWM)
/Tsy4_5: MD8.7 (Q3A), U4.7 (5_TX1_PWM)
/Tsy4_6: MD8.8 (Q3B), U4.8 (6_PWM)
/Tsy4_7: MD8.9 (Q4A), U4.9 (7_RX3_DOUT)
/Tsy4_8: MD8.10 (Q4B), U4.10 (8_TX3_DIN)
/Tsy4_9: MD4.7 (Q3A), U4.11 (9_RX2_CS_PWM)
/Tsy4_10: MD4.8 (Q3B), U4.12 (10_TX2_CS_PWM)
/Tsy4_11: MD4.9 (Q4A), U4.13 (11_DOUT)
/Tsy4_12: MD4.10 (Q4B), U4.14 (12_DIN)
/Tsy4_14: MD12.7 (Q3A), U4.21 (14_A0_SCK)
/Tsy4_15: MD13.10 (Q4B), U4.22 (15_A1_CS_Touch)
/Tsy4_16: MD13.9 (Q4A), U4.23 (16_A2_SCL0_Touch)
/Tsy4_17: MD13.8 (Q3B), U4.24 (17_A3_SDA0_Touch)
/Tsy4_20: MD13.7 (Q3A), U4.27 (20_A6_CS_PWM)
/Tsy4_21: MD13.6 (Q2B), U4.28 (21_A7_RX1_CS_PWM)
/Tsy4_22: MD13.5 (Q2A), U4.29 (22_A8_Touch_PWM)
/Tsy4_23: MD13.4 (Q1B), U4.30 (23_A9_Touch_PWM)
/Tsy4_24: MD14.6 (Q2B), U4.52 (24)
/Tsy4_25: MD14.5 (Q2A), U4.51 (25_Touch_PWM)
/Tsy4_26: MD14.4 (Q1B), U4.50 (26_A15_RX2)
/Tsy4_27: MD14.3 (Q1A), U4.49 (27_A16)
/Tsy4_28: U4.48 (28_A17)
/Tsy4_29: MD13.3 (Q1A), U4.47 (29_A18_SCL1)
/Tsy4_30: MD14.10 (Q4B), U4.46 (30_A19_SDA1)
/Tsy4_31: MD14.9 (Q4A), U4.45 (31_A20_TX2)
/Tsy4_32: MD14.8 (Q3B), U4.44 (32_Touch_PWM)
/Tsy4_33: MD14.7 (Q3A), U4.43 (33_Touch)
MD1_SCL: JP29.2 (B), MD1.11 (SCL)
MD1_SDA: JP48.2 (B), MD1.12 (SDA)
MD1_VCC: JP5.1 (A), JP8.1 (A), MD1.1 (VCC), MD2.1 (VCC), MD3.1 (VCC), MD4.1 (VCC)
MD1_VPWR: F1.2, JP12.2 (B), MD1.13 (VCCPWR)
MD2_SCL: JP30.2 (B), MD2.11 (SCL)
MD2_SDA: JP49.2 (B), MD2.12 (SDA)
MD2_VPWR: F2.2, JP13.2 (B), MD2.13 (VCCPWR)
MD3_SCL: JP31.2 (B), MD3.11 (SCL)
MD3_SDA: JP50.2 (B), MD3.12 (SDA)
MD3_VPWR: F3.2, JP14.2 (B), MD3.13 (VCCPWR)
MD4_SCL: JP32.2 (B), MD4.11 (SCL)
MD4_SDA: JP51.2 (B), MD4.12 (SDA)
MD4_VPWR: F4.2, JP15.2 (B), MD4.13 (VCCPWR)
MD5_SCL: JP33.2 (B), MD5.11 (SCL)
MD5_SDA: JP52.2 (B), MD5.12 (SDA)
MD5_VCC: JP5.2 (B), JP6.1 (A), JP9.1 (A), MD5.1 (VCC), MD6.1 (VCC), MD7.1 (VCC), MD8.1 (VCC)
MD5_VPWR: F5.2, JP16.2 (B), MD5.13 (VCCPWR)
MD6_SCL: JP34.2 (B), MD6.11 (SCL)
MD6_SDA: JP53.2 (B), MD6.12 (SDA)
MD6_VPWR: F6.2, JP17.2 (B), MD6.13 (VCCPWR)
MD7_SCL: JP37.2 (B), MD7.11 (SCL)
MD7_SDA: JP54.2 (B), MD7.12 (SDA)
MD7_VPWR: F7.2, JP18.2 (B), MD7.13 (VCCPWR)
MD8_SCL: JP38.2 (B), MD8.11 (SCL)
MD8_SDA: JP55.2 (B), MD8.12 (SDA)
MD8_VPWR: F8.2, JP19.2 (B), MD8.13 (VCCPWR)
MD9_SCL: JP39.2 (B), MD9.11 (SCL)
MD9_SDA: JP56.2 (B), MD9.12 (SDA)
MD9_VPWR: F9.2, JP20.2 (B), MD9.13 (VCCPWR)
MD10_GND: H1.1, H2.1, H3.1, H4.1, J1.2, J1.3, J2.2, J2.3, J3.2, J3.3, J4.2, J4.3, J5.2, J5.3, J11.1, J12.1, J13.1, J14.1, J15.1, J16.A1_B12 (GND), J16.B1_A12 (GND), J16.SH1 (SHELL_GND), J16.SH2 (SHELL_GND), J16.SH3 (SHELL_GND), J16.SH4 (SHELL_GND), J18.5, J18.6 (MH1), J18.7 (MH2), J18.8 (MH3), J18.9 (MH4), MD1.2 (GND), MD1.14 (GNDPWR), MD2.2 (GND), MD2.14 (GNDPWR), MD3.2 (GND), MD3.14 (GNDPWR), MD4.2 (GND), MD4.14 (GNDPWR), MD5.2 (GND), MD5.14 (GNDPWR), MD6.2 (GND), MD6.14 (GNDPWR), MD7.2 (GND), MD7.14 (GNDPWR), MD8.2 (GND), MD8.14 (GNDPWR), MD9.2 (GND), MD9.14 (GNDPWR), MD10.2 (GND), MD10.14 (GNDPWR), MD11.2 (GND), MD11.14 (GNDPWR), MD12.2 (GND), MD12.14 (GNDPWR), MD13.2 (GND), MD13.14 (GNDPWR), MD14.2 (GND), MD14.14 (GNDPWR), R1.2, R2.1, R3.2, R4.2, R5.2, R6.2, R7.2, U1.1 (GND), U2.1 (GND), U3.1 (GND), U4.1 (GND)
MD10_SCL: JP42.2 (B), MD10.11 (SCL)
MD10_SDA: JP57.2 (B), MD10.12 (SDA)
MD10_VCC: JP6.2 (B), JP7.1 (A), JP10.1 (A), MD9.1 (VCC), MD10.1 (VCC), MD11.1 (VCC), MD12.1 (VCC)
MD10_VPWR: F10.2, JP21.2 (B), MD10.13 (VCCPWR)
MD11_SCL: JP43.2 (B), MD11.11 (SCL)
MD11_SDA: JP58.2 (B), MD11.12 (SDA)
MD11_VPWR: F11.2, JP22.2 (B), MD11.13 (VCCPWR)
MD12_SCL: JP44.2 (B), MD12.11 (SCL)
MD12_SDA: JP59.2 (B), MD12.12 (SDA)
MD12_VPWR: F12.2, JP23.2 (B), MD12.13 (VCCPWR)
MD13_SCL: JP47.2 (B), MD13.11 (SCL)
MD13_SDA: JP60.2 (B), MD13.12 (SDA)
MD13_VCC: JP7.2 (B), JP11.1 (A), JP69.1 (A), MD13.1 (VCC), MD14.1 (VCC)
MD13_VPWR: F13.2, JP24.2 (B), MD13.13 (VCCPWR)
MD14_SCL: JP75.2 (B), MD14.11 (SCL)
MD14_SDA: JP74.2 (B), MD14.12 (SDA)
MD14_VPWR: F14.2, JP25.2 (B), MD14.13 (VCCPWR)
unnamed: D1.1 (K), R3.1
unnamed: D2.1 (K), R4.1
unnamed: D3.1 (K), R5.1
unnamed: D4.1 (K), R6.1
unnamed: D5.1 (K), R7.1
unnamed: J16.A5 (CC1), R2.2
unnamed: J16.B5 (CC2), R1.1
unnamed: JP26.1 (A), JP28.2 (B), JP29.1 (A), JP30.1 (A), JP31.1 (A), JP32.1 (A), TP1.1
unnamed: JP27.1 (A), JP33.1 (A), JP34.1 (A), JP36.2 (B), JP37.1 (A), JP38.1 (A), TP2.1
unnamed: JP35.1 (A), JP39.1 (A), JP41.2 (B), JP42.1 (A), JP43.1 (A), JP44.1 (A), TP3.1
unnamed: JP40.1 (A), JP46.2 (B), JP47.1 (A), JP75.1 (A), TP4.1
unnamed: JP45.1 (A), JP48.1 (A), JP49.1 (A), JP50.1 (A), JP51.1 (A), JP62.2 (B), TP5.1
unnamed: JP52.1 (A), JP53.1 (A), JP54.1 (A), JP55.1 (A), JP61.1 (A), JP64.2 (B), TP6.1
unnamed: JP56.1 (A), JP57.1 (A), JP58.1 (A), JP59.1 (A), JP63.1 (A), JP66.2 (B), TP7.1
unnamed: JP60.1 (A), JP65.1 (A), JP68.2 (B), JP74.1 (A), TP8.1
SCL: JP26.2 (B), JP27.2 (B), JP35.2 (B), JP40.2 (B)
SDA: JP45.2 (B), JP61.2 (B), JP63.2 (B), JP65.2 (B)
Tsy1_3V3: JP8.2 (B), U1.31 (3.3V)
Tsy1_SCL: JP28.1 (A), U1.26 (19_A5_SCL0_Touch)
Tsy1_SDA: JP62.1 (A), U1.25 (18_A4_SDA0_Touch)
Tsy1_Vin: JP70.2 (B), JP71.1 (A), U1.33 (Vin)
Tsy2_3V3: JP9.2 (B), U2.31 (3.3V)
Tsy2_SCL: JP36.1 (A), U2.26 (19_A5_SCL0_Touch)
Tsy2_SDA: JP64.1 (A), U2.25 (18_A4_SDA0_Touch)
Tsy2_Vin: JP71.2 (B), JP72.1 (A), U2.33 (Vin)
Tsy3_3V3: JP10.2 (B), U3.31 (3.3V)
Tsy3_SCL: JP41.1 (A), U3.26 (19_A5_SCL0_Touch)
Tsy3_SDA: JP66.1 (A), U3.25 (18_A4_SDA0_Touch)
Tsy3_Vin: JP72.2 (B), JP73.1 (A), U3.33 (Vin)
Tsy4_3V3: JP11.2 (B), U4.31 (3.3V)
Tsy4_SCL: JP46.1 (A), U4.26 (19_A5_SCL0_Touch)
Tsy4_SDA: JP68.1 (A), U4.25 (18_A4_SDA0_Touch)
Tsy4_Vin: JP73.2 (B), U4.33 (Vin)

Notes on the sheet:
MPower for Motor Driver, zones
Power Management
USB Pwr input
VCCPower for Motor Driver, w/ zones
Note: +15V_X 5A; GNDPWR 25A
Goals: Power: Power<-PowerSupply Power-Zones Power->Motor Driver Boards; Power->Encoders Fuse to prevent Overheating Comm: Connect I2C of MCU, MotorDrivers and backup for old boards Connect Encoder Output to MCU LED indicator for Encoder LED on 2 different power up Mounting Mount for Moto Driver, F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
I2C Comm

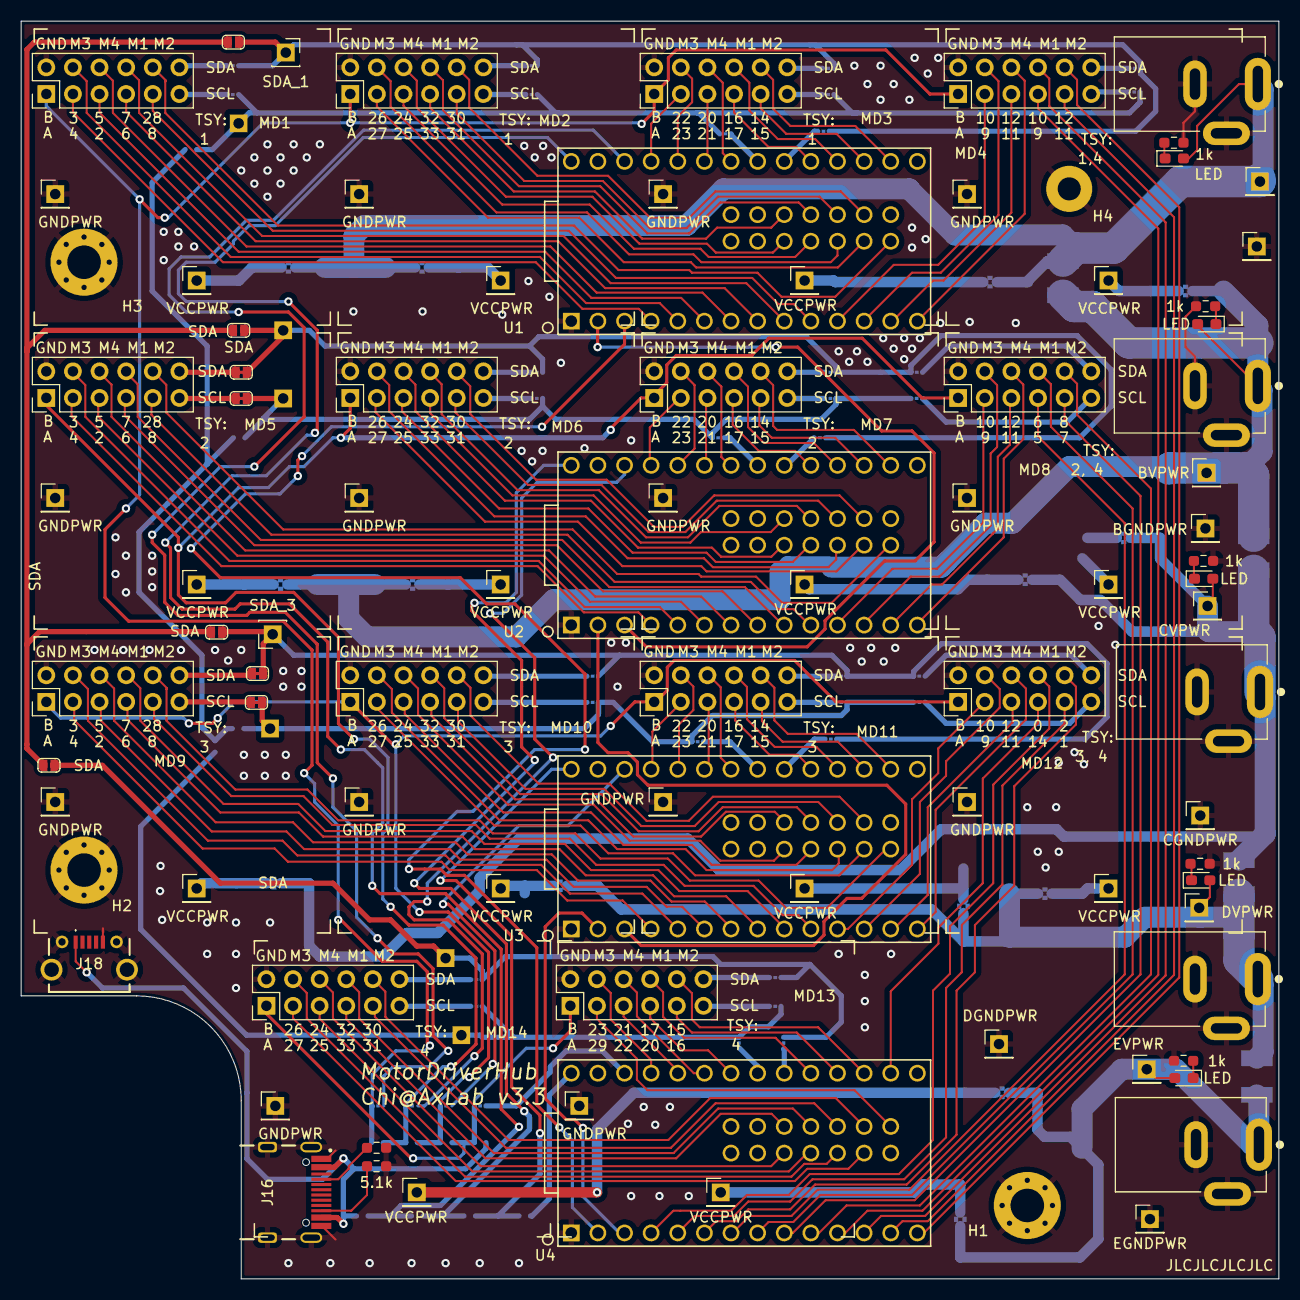
[picture p27: board MotorHub5x5.kicad_pcb from above]

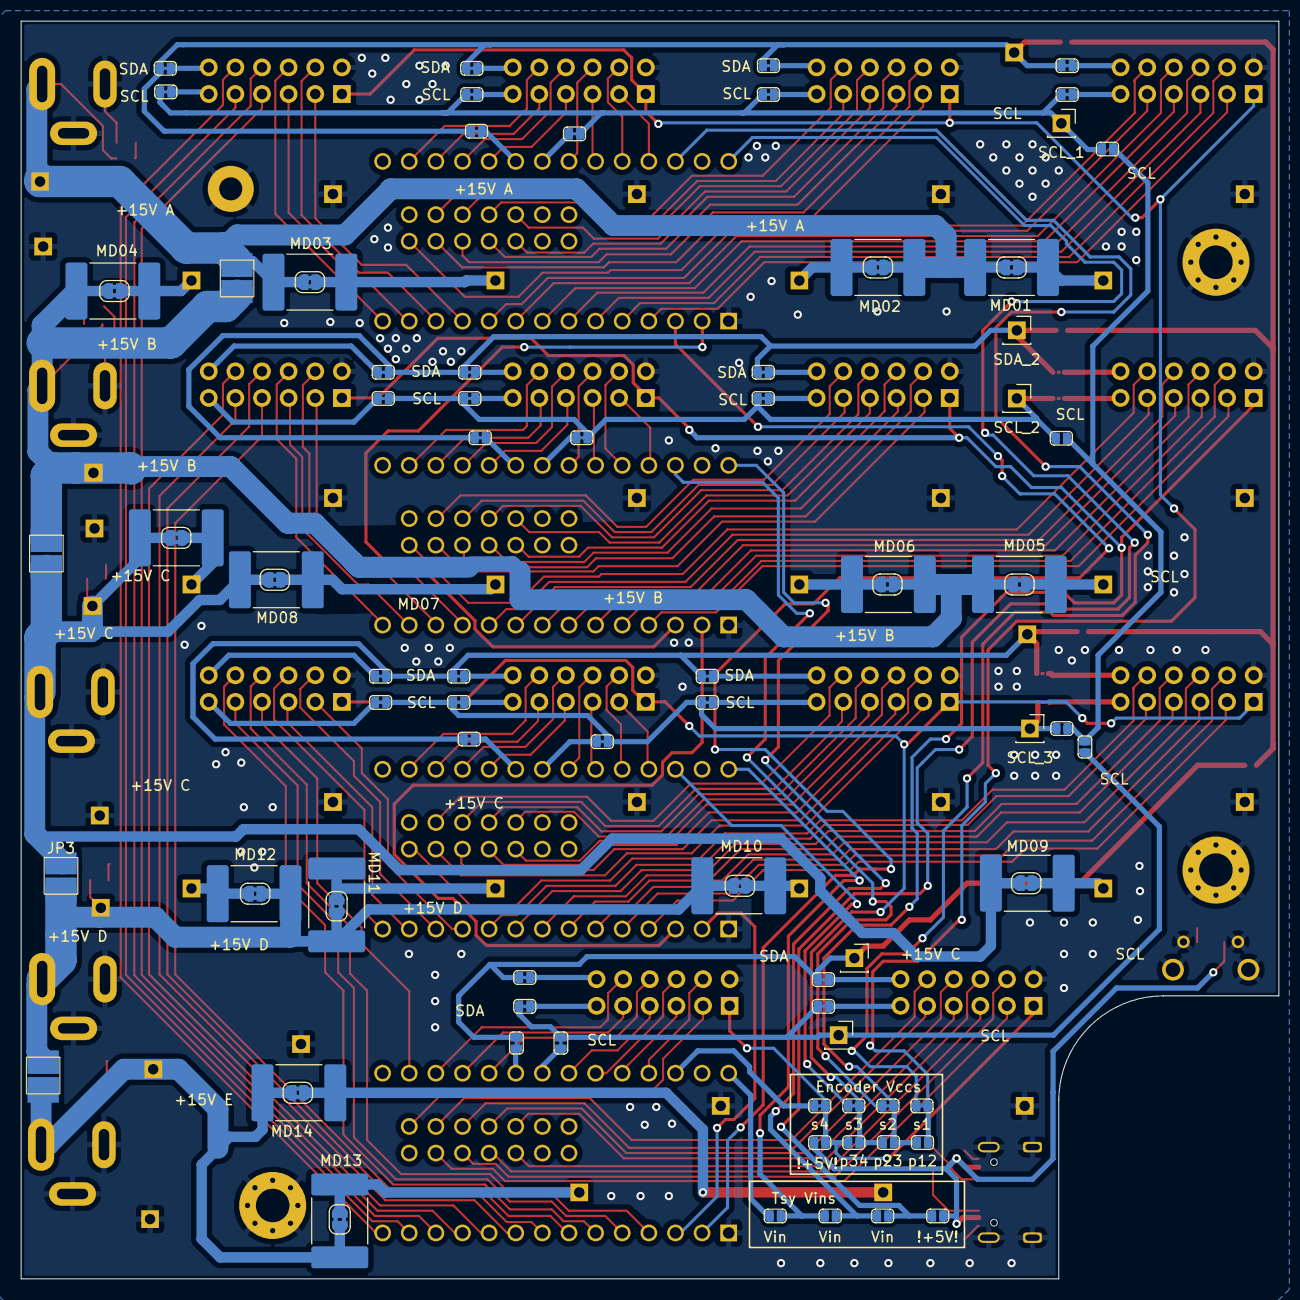
[picture p28: board MotorHub5x5.kicad_pcb from below]

Board: 2 copper layers, 120.0 x 120.0 mm, 147 parts (86 on the bottom side), 202 nets.
