AxLab-UofC/GranularIO/Hardware/LAPM/PCB Kicad Files/4_MotherBoard_PCB/draft/draft.kicad_pcb

## KiCad design Hardware/LAPM/PCB Kicad Files/4_MotherBoard_PCB/draft/draft.kicad_pcb (2026-10-10)

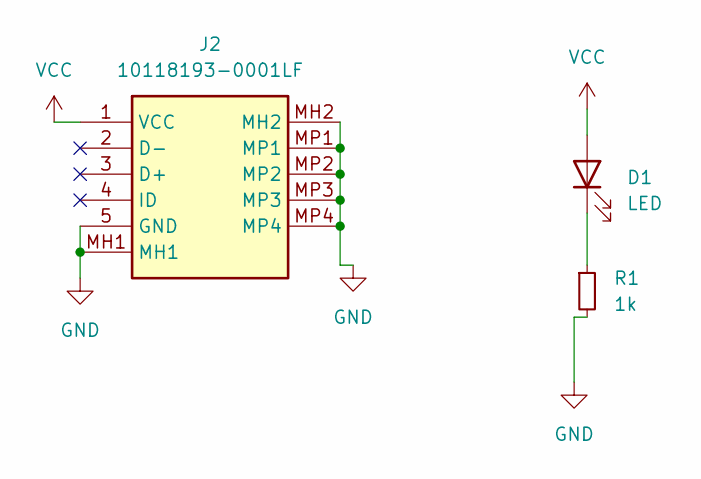
[picture p29: schematic draft.kicad_sch]

Parts:
D1: LED; LED_0603_1608Metric_Pad1.05x0.95mm_HandSolder
J2: 10118193-0001LF; 101181930001LF; Manufacturer_Part_Number 10118193-0001LF
R1: 1k; R_0603_1608Metric_Pad0.98x0.95mm_HandSolder

Connections:
GND: J2.5 (GND), J2.MH1, J2.MH2, J2.MP1, J2.MP2, J2.MP3, J2.MP4, R1.2
unnamed: D1.1 (K), R1.1
VCC: D1.2 (A), J2.1 (VCC)

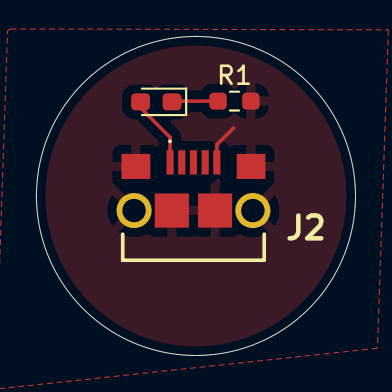
[picture p30: board draft.kicad_pcb from above]

Board: 2 copper layers, 17.7 x 17.7 mm, 3 parts (0 on the bottom side), 3 nets.
