AxLab-UofC/GranularIO/Hardware/LAPM/PCB Kicad Files/5_MotorDriverBoard_PCB_Kicad/MotorController.kicad_pcb

## KiCad design Hardware/LAPM/PCB Kicad Files/5_MotorDriverBoard_PCB_Kicad/MotorController.kicad_pcb (2026-10-10)

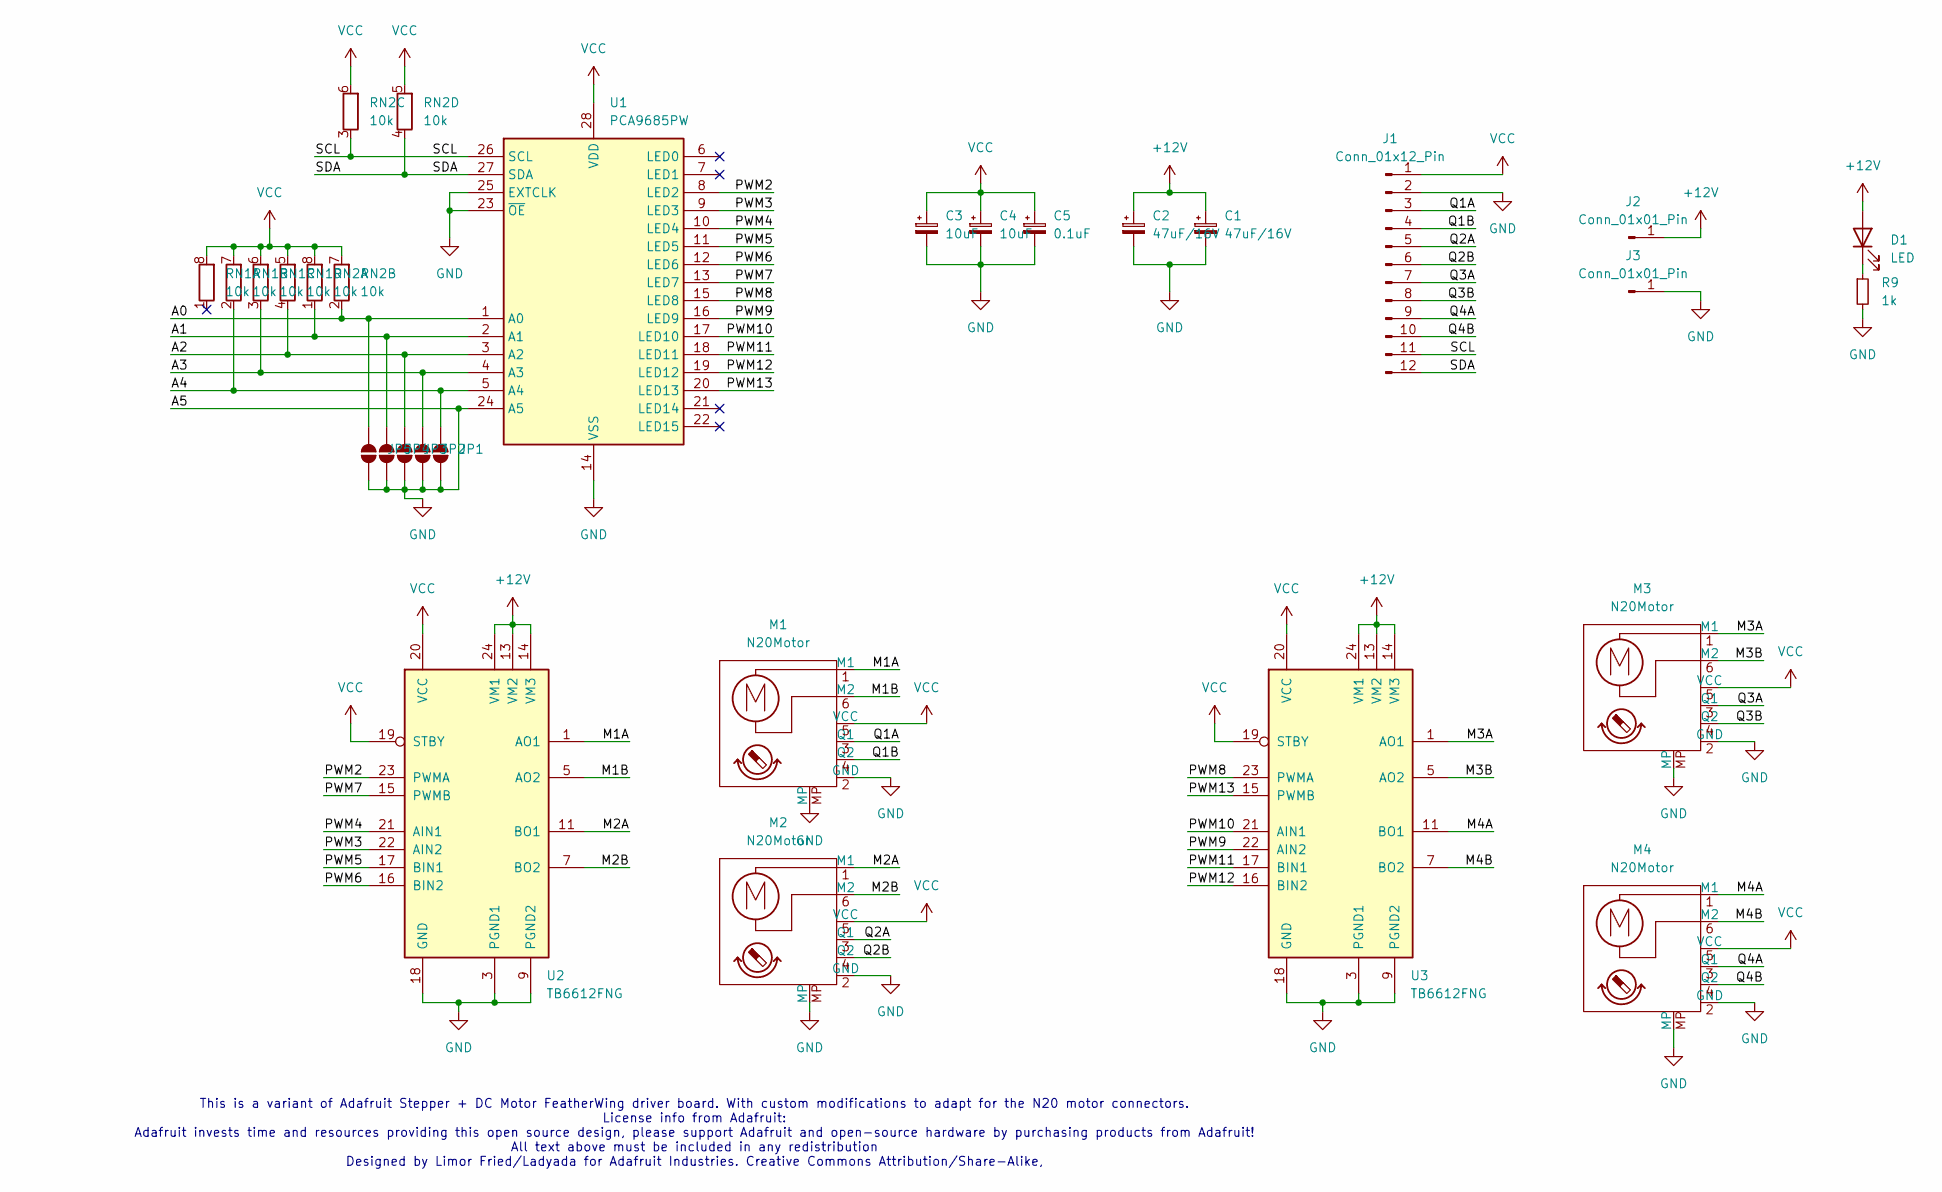
[picture p31: schematic MotorController.kicad_sch]

Parts:
C1, C2: 47uF/16V; CP_Elec_6.3x5.4
C3, C4: 10uF; C_0603_1608Metric_Pad1.08x0.95mm_HandSolder
C5: 0.1uF; C_0603_1608Metric_Pad1.08x0.95mm_HandSolder
D1: LED; LED_0603_1608Metric_Pad1.05x0.95mm_HandSolder
J1: Conn_01x12_Pin; PinHeader_2x06_P2.54mm_Vertical_SMD; LCSC C22395610
J2, J3: Conn_01x01_Pin; PinHeader_1x01_P2.54mm_Vertical
JP1, JP2, JP3, JP4, JP5: SolderJumper-2_Open_RoundedPad
M1, M2, M3, M4: N20Motor; N20MotorConn
R9: 1k; R_0603_1608Metric_Pad0.98x0.95mm_HandSolder
RN1, RN2: 10k; R_Array_Convex_4x0603; LCSC C29718
U1: PCA9685PW; TSSOP-28_4.4x9.7mm_P0.65mm; LCSC C2678753
U2, U3: TB6612FNG; SSOP-24_5.3x8.2mm_P0.65mm; LCSC C141517

Connections:
+12V: C1.1, C2.1, D1.2 (A), J2.1, U2.13 (VM2), U2.14 (VM3), U2.24 (VM1), U3.13 (VM2), U3.14 (VM3), U3.24 (VM1)
/A0: JP5.2 (B), RN2.2 (R2.1), U1.1 (A0)
/A1: JP4.2 (B), RN2.1 (R1.1), U1.2 (A1)
/A2: JP3.2 (B), RN1.4 (R4.1), U1.3 (A2)
/A3: JP2.2 (B), RN1.3 (R3.1), U1.4 (A3)
/A4: JP1.2 (B), RN1.2 (R2.1), U1.5 (A4)
/M1A: M1.1 (M1), U2.1 (AO1), U2.2 (AO1)
/M1B: M1.6 (M2), U2.5 (AO2), U2.6 (AO2)
/M2A: M2.1 (M1), U2.11 (BO1), U2.12 (BO1)
/M2B: M2.6 (M2), U2.7 (BO2), U2.8 (BO2)
/M3A: M3.1 (M1), U3.1 (AO1), U3.2 (AO1)
/M3B: M3.6 (M2), U3.5 (AO2), U3.6 (AO2)
/M4A: M4.1 (M1), U3.11 (BO1), U3.12 (BO1)
/M4B: M4.6 (M2), U3.7 (BO2), U3.8 (BO2)
/PWM2: U1.8 (LED2), U2.23 (PWMA)
/PWM3: U1.9 (LED3), U2.22 (AIN2)
/PWM4: U1.10 (LED4), U2.21 (AIN1)
/PWM5: U1.11 (LED5), U2.17 (BIN1)
/PWM6: U1.12 (LED6), U2.16 (BIN2)
/PWM7: U1.13 (LED7), U2.15 (PWMB)
/PWM8: U1.15 (LED8), U3.23 (PWMA)
/PWM9: U1.16 (LED9), U3.22 (AIN2)
/PWM10: U1.17 (LED10), U3.21 (AIN1)
/PWM11: U1.18 (LED11), U3.17 (BIN1)
/PWM12: U1.19 (LED12), U3.16 (BIN2)
/PWM13: U1.20 (LED13), U3.15 (PWMB)
/Q1A: J1.3, M1.3 (Q1)
/Q1B: J1.4, M1.4 (Q2)
/Q2A: J1.5, M2.3 (Q1)
/Q2B: J1.6, M2.4 (Q2)
/Q3A: J1.7, M3.3 (Q1)
/Q3B: J1.8, M3.4 (Q2)
/Q4A: J1.9, M4.3 (Q1)
/Q4B: J1.10, M4.4 (Q2)
/SCL: J1.11, RN2.3 (R3.1), U1.26 (SCL)
/SDA: J1.12, RN2.4 (R4.1), U1.27 (SDA)
GND: C1.2, C2.2, C3.2, C4.2, C5.2, J1.2, J3.1, JP1.1 (A), JP2.1 (A), JP3.1 (A), JP4.1 (A), JP5.1 (A), M1.2 (GND), M1.MP, M2.2 (GND), M2.MP, M3.2 (GND), M3.MP, M4.2 (GND), M4.MP, R9.2, U1.14 (VSS), U1.23 (~OE), U1.24 (A5), U1.25 (EXTCLK), U2.3 (PGND1), U2.4 (PGND1), U2.9 (PGND2), U2.10 (PGND2), U2.18 (GND), U3.3 (PGND1), U3.4 (PGND1), U3.9 (PGND2), U3.10 (PGND2), U3.18 (GND)
unnamed: D1.1 (K), R9.1
VCC: C3.1, C4.1, C5.1, J1.1, M1.5 (VCC), M2.5 (VCC), M3.5 (VCC), M4.5 (VCC), RN1.5 (R4.2), RN1.6 (R3.2), RN1.7 (R2.2), RN1.8 (R1.2), RN2.5 (R4.2), RN2.6 (R3.2), RN2.7 (R2.2), RN2.8 (R1.2), U1.28 (VDD), U2.19 (STBY), U2.20 (VCC), U3.19 (STBY), U3.20 (VCC)

Notes on the sheet:
This is a variant of Adafruit Stepper + DC Motor FeatherWing driver board. With custom modifications to adapt for the N20 motor connectors. License info from Adafruit: Adafruit invests time and resources providing this open source design, please support Adafruit and open-source hardware by purchasi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

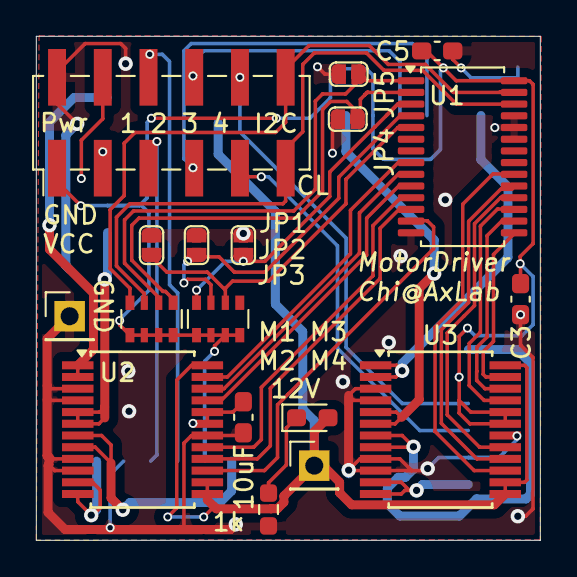
[picture p32: board MotorController.kicad_pcb from above]

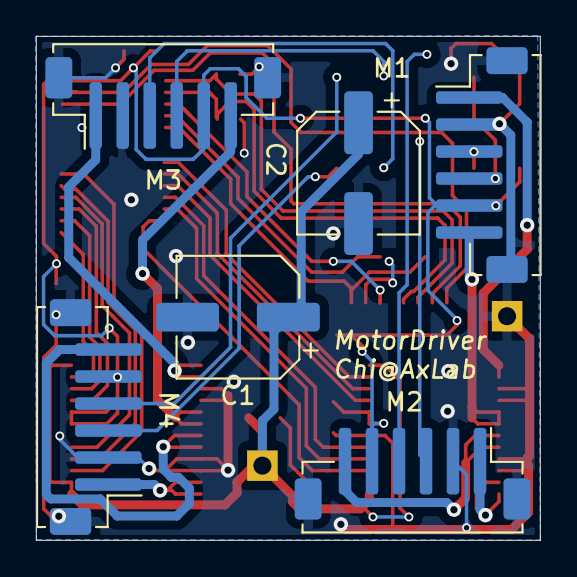
[picture p33: board MotorController.kicad_pcb from below]

Board: 2 copper layers, 28.0 x 28.0 mm, 24 parts (6 on the bottom side), 39 nets.
