AxLab-UofC/GranularIO/(commit log)

2026-06-29 Added GUI code
    [bom.xlsx]
2026-10-10 Add files for magnet pin fabrication
    [MagnetHolder_Oct3.3mf]
2026-10-10 Adding PCB files
    [MotorController-B_Cu.gbl, MotorController-B_Mask.gbs, MotorController-B_Paste.gbp, MotorController-B_Silkscreen.gbo, MotorController-Edge_Cuts.gm1, MotorController-F_Cu.gtl, MotorController-F_Mask.gts, MotorController-F_Paste.gtp]
2026-10-10 Sort 3D print files in to a folder
    [MagnetHolder_Oct3.3mf]
2026-11-02 prep for publication
    [MagnetHolder_Oct3.3mf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]
2026-11-02 Added License Text per Adafruit redistribution requirements.
    [MotorController.kicad_sch]
2026-11-02 Update text pos
    [MotorHub5x5.kicad_sch]
2026-11-02 Uploaded PCB and LAMP assembly files. Updated readme
    [1_Rail_Array.stl, 2_Motor_Hub.stl, 3_Supporting_Beam_a.stl, 3_Supporting_Beam_b.stl, 3_Supporting_Beam_c.stl, 3_Supporting_Beam_d.stl, 6_1_Magnet_Holder.stl, 6_2_Screw_Connector.stl]
2026-11-02 Uploading EM files.
    [1_EM_Cover.stl, 2_EM_Hub.stl, 3_MetalDisk.step, MagnetHolder_Oct3.3mf, Sphere_5mm_mini.3mf, Sphere_5mm_support_test.3mf]
2026-11-02 update readme
    Updated motor links and improved formatting for clarity.
2026-11-02 update readme
    Updated the motor link to specify 'Pololu Alternative'
2026-11-02 update readme
    Updated instructions for assembling the magnet pin and added links to motor and components.
