AxLab-UofC/GranularIO/(notices)

Notices in the files:
Hardware/LAPM/PCB Kicad Files/5_MotorDriverBoard_PCB_Kicad/MotorController.kicad_sch:
Designed by Limor Fried/Ladyada for Adafruit Industries. Creative Commons Attribution/Share-Alike,
